EEJeffMan/NAS_Controller/README.md

# NAS_Controller
This is a PCB that serves as a controller for power supplies and provides power/reset control for a Pi-based NAS.
