EEJeffMan/NAS_Controller/PCB/BOM/NAS_Controller.xls

Reference | Quantity | Value | Footprint | Datasheet | Current | Voltage | Package | Mfg | P/N | Impedance | Power | Bias_Current | DCR | Vin | max | Field4 | Field5 | Field6 | Field7 | Field8 | Current - Hold | Field9 | Field10
C1 C23 C32 C44 C45 C55 C58 C64 C65 C66 C67 C7 C70 C71 C73 C74 C82 C83 C84 C93 C94 C98 | 22 | 0.1uF | Capacitors_SMD:C_0603 |  |  | ,50V" | 603 |  | GCJ188R71H104KA12D | , | , | , | , | , | ,
C12 C13 C27 C28 C29 C37 C38 C39 C53 C54 C60 C61 C77 C78 ,14,22uF" | 14 | 22uF | Capacitors_SMD:C_0805 |  |  | ,10V" | 805 |  | C2012X5R1A226M085AC | , | , | , | , | , | ,
C15 C31 C41 ,3,1000pF" | 3 | 1000pF | Capacitors_SMD:C_0603 |  |  | ,50V" | 603 |  | GCM188R71H102KA37D | , | , | , | , | , | ,
C17 C21 C85 C86 ,4,2.2uF" | 4 | 2.2uF | Capacitors_SMD:C_1206 |  |  | ,50V" | 1206 |  | C2012X5R1H225M085AB | , | , | , | , | , | ,
C18 C19 C47 C48 C49 C50 C51 C52 C57 C62 C63 C72 C75 C76 C80 ,15,2.2uF" | 15 | 2.2uF | Capacitors_SMD:C_0603 |  |  | ,16V" | 603 |  | CL10A225KO8NNNC | , | , | , | , | , | ,
C10 C11 C2 C24 C25 C26 C3 C34 C35 C36 C4 C5 C81 C87 C88 C89 C90 C91 C96 ,19,22uF" | 19 | 22uF | Capacitors_SMD:C_1206 |  |  | ,50V" | 1206 |  | C3216X5R1V226M160AC | , | , | , | , | , | ,
C100 C101 C102 C103 C104 C105 C106 C107 C108 C109 C110 C111 C112 C114 C14 C20 C30 C40 C6 C9 C92 C99 ,22,0.01uF" | 22 | 0.01uF | Capacitors_SMD:C_0603 |  |  | ,10V" | 603 |  | 06035C103JAT4A | GCM188R71H103KA37J | , | , | , | , | ,
C68 C69 ,2,33pF" | 2 | 33pF | Capacitors_SMD:C_0603 |  |  | ,50V" | 603 |  | CL10C330FB8NNNC | , | , | , | , | , | ,
C113 C16 C22 C33 C42 C43 C46 C56 C59 C79 C8 C95 C97 ,13,100pF" | 13 | 100pF | Capacitors_SMD:C_0603 |  |  | ,25V" | 603 |  | C0603C101M5RAC7867 | , | , | , | , | , | ,
D1 D11 D13 D21 D5 ,5,SBR8U60P5-13" | 5 | SBR8U60P5-13 | PowerDI5:Diodes_Incorporated_POWERDI_5 |  | 8A | 60V | , |  | SBR8U60P5-13 | , | , | , | , | , | ,
D14 D15 D16 D17 D18 D19 D20 | 7 | BAS40BRW-7-F | TO_SOT_Packages_SMD:SOT-363_SC-70-6 |  |  |  |  |  | BAS40BRW-7-F
D2 D6 D7 | 3 | 15MQ060NTR | Diodes_SMD:D_SMA |  | 2.1A | 60V | , |  | 15MQ060NTR | , | , | , | , | , | ,
D22 | 1 | Red | LEDs:LED_0603_HandSoldering |  |  |  |  |  | LTST-C190KRKT
D23 | 1 | Yellow | LEDs:LED_0603_HandSoldering |  |  |  |  |  | LTST-C191KSKT
D24 | 1 | Green | LEDs:LED_0603_HandSoldering |  |  |  |  |  | LTST-C190KGKT
D3 D8 | 2 | 5.6V | Diodes_SMD:D_SOD-123 |  | , | , | ,50uA" |  | MMSZ4690T3G | SZMMSZ4690ET1G | , | , | , | ,
D10 D12 D4 | 3 | 15V | Diodes_SMD:D_SOD-123 |  |  |  |  |  | MMSZ4702-TP
D9 | 1 | 3.3V | Diodes_SMD:D_SOD-123 |  |  |  |  |  | BZT52C3V3-7-F
F1 F2 F3 | 3 | 2920L300/15DR | 2920L:2920L |  | ,15V" | , | , |  | 2920L300/15DR | , | , | , | ,3A" | ,
FL1 | 1 | ACM12V-701-2PL-TL00 | CustomFootprints:IND_ACM12V-701-2PL-TL00_FixedPadNumbers |  | 8A | , | 700 Ohms |  | ACM12V-701-2PL-TL00 | , | , | , | , | , | ,
J1 | 1 | Barrel_Jack | Connectors:BARREL_JACK |  | 5A | , | , |  | PJ-002AH | , | , | , | , | ,
J10 ,1,Conn_01x10" | 1 | Conn_01x10 |  |  |  |  |  |  | PREC010SBAN-M71RC
J13 J15 | 2 | Conn_01x03 | Pin_Headers:Pin_Header_Straight_1x03_Pitch2.54mm_SMD_Pin1Right |  |  |  |  |  | 878980314
J14 | 1 | 20021121-00020C4LF | Socket_Strips:Socket_Strip_Straight_2x10_Pitch1.27mm_SMD |  |  |  |  |  | 20021121-00020C4LF
J18 | 1 | M20-9990246 | Pin_Headers:Pin_Header_Straight_1x02_Pitch2.54mm |  |  |  |  |  | M20-9990246
J2 | 1 | Conn_01x04 | Connectors_Molex:Molex_MiniFit-JR-5569-04A1_2x02x4.20mm_Angled |  |  |  |  |  | 39291048
J3 | 1 | 105133-0011 | 105133-0011:MOLEX_105133-0011 | 0.57 USD | , | , | , |  | 105133-0011 | , | 105133-0011 | Conn Micro USB Type B RCP 5 POS 0.65mm Solder ST SMD 5 Terminal 1 Port Embossed T/R | Good | None | Molex | ,
J11 J4 ,2,10103594-0001LF" | 2 | 10103594-0001LF |  |  |  |  |  |  | 10103594-0001LF
J5 J6 | 2 | NPPN101BFCN-RC | Socket_Strips:Socket_Strip_Straight_1x10_Pitch2.00mm |  |  |  |  |  | NPPN101BFCN-RC
J7 | 1 | Conn_01x03 | Pin_Headers:Pin_Header_Straight_1x03_Pitch2.54mm |  |  |  |  |  | SWR25X-NRTC-S03-ST-BA
J8 J9 | 2 | PPTC081LFBN-RC | Socket_Strips:Socket_Strip_Straight_1x08_Pitch2.54mm |  |  |  |  |  | PPTC081LFBN-RC
L1 L3 L5 | 3 | 1uH | INDP2622X120N:INDP2622X120N |  | 3.4A | , | , |  | SRP2512-1R0M | ,49 mOhm" | , | , | , | ,
L2 ,1,47uH" | 1 | 47uH | CustomFootprints:Inductor_Taiyo-Yuden_NR-80xx_HandSoldering |  | 1.55A | , | , |  | TYS8040470M-10 | , | , | , | , | ,
L4 L6 ,2,22uH" | 2 | 22uH | CustomFootprints:L_12x12mm_h8mm_hand_soldering |  | 4.3A | , | , |  | SRR1280-220M | ,38.6 mOhm" | , | , | , | ,
L7 ,1,20uH" | 1 | 20uH | CustomFootprints:IND_C_12_5MMX12_5MM_HandSoldering |  | 3.02A | , | , |  | SRF1280-100M | , | , | , | , | ,
Q1 Q10 Q4 Q6 Q8 Q9 | 6 | AOD409 | TO_SOT_Packages_SMD:TO-252-2 |  | 26A | 60V | , |  | AOD409 | , | , | , | , | , | ,
Q13 | 1 | DMN6068LK3-13 | TO_SOT_Packages_SMD:TO-252-2 |  | 6A | 60V | , |  | DMN6068LK3-13 | , | , | , | , | , | ,
Q11 Q12 Q14 Q2 Q5 Q7 | 6 | DMG1026UV-7 | digikey-footprints:SOT-563 |  |  |  |  |  | DMG1026UV-7
Q3 | 1 | FZT600BTA | TO_SOT_Packages_SMD:SOT-223 |  | 2A | 140V | , |  | FZT600BTA | CZTA14 TR | , | , | , | , | ,
R1 | 1 | 0.01 Ohm | Resistors_SMD:R_1206 |  | , | 1206 | ,1/2W" |  | ERJ-8CWFR010V | , | , | , | , | ,
R102 R115 R116 R13 R14 ,5,2.2k" | 5 | 2.2k | Resistors_SMD:R_0603 |  | , | 603 | , |  | RC0603FR-072K2L | , | , | , | , | ,
R134 ,1,649 Ohm" | 1 | 649 Ohm | Resistors_SMD:R_0603 |  | , | 603 | , |  | RC0603FR-07649RL | , | , | , | , | ,
R133 R135 R71 R85 R87 ,5,1M" | 5 | 1M | Resistors_SMD:R_0603 |  | , | 603 | , |  | MCT06030C1004FP500 | , | , | , | , | ,
R15 R32 R45 ,3,499" | 3 | 499 Ohm | Resistors_SMD:R_1206 |  | , | 1206 | , |  | ERJ-8ENF4990V | , | , | , | , | ,
R110 R111 R17 R18 R34 R36 R48 R49 R56 R58 R67 R68 ,12,49.9k" | 12 | 49.9k | Resistors_SMD:R_0603 |  | , | 603 | , |  | ERJ-3EKF4992V | , | , | , | , | ,
R10 R100 R101 R107 R109 R11 R112 R113 R118 R121 R122 R123 R124 R125 R126 R127 R128 R129 R130 R131 R132 R19 R2 R21 R22 R26 R27 R28 R35 R39 R4 R40 R41 R47 R50 R51 R52 R59 R60 R61 R69 R7 R70 R72 R73 R76 R79 R80 R81 R82 R83 R88 R89 R9 R90 R91 R92 R93 R94 R95 R97 R98 R99 ,63,10k" | 63 | 10k | Resistors_SMD:R_0603 |  | , | 603 | , |  | ERJ-3EKF1002V | , | , | , | , | ,
R20 ,1,4.3k" | 1 | 4.3k | Resistors_SMD:R_1206 |  | , | 1206 | , |  | RC1206FR-074K3L | , | , | , | , | ,
R104 R106 R12 R23 R29 R3 R30 R31 R42 R43 R44 R53 R54 R6 R64 R66 ,16,1k" | 16 | 1k | Resistors_SMD:R_0603 |  | , | 603 | , |  | ERJ-3EKF1001V | , | , | , | , | ,
R108 R16 R33 R46 R5 R57 R65 ,7,100 Ohm" | 7 | 100 Ohm | Resistors_SMD:R_0603 |  | , | 603 | , |  | ERJ-3EKF1000V | , | , | , | , | ,
R55 R74 R75 R77 R78 R84 ,6,100k" | 6 | 100k | Resistors_SMD:R_0603 |  | , | 603 | , |  | ERJ-3EKF1003V | , | , | , | , | ,
R105 R117 R119 R120 R62 R96 ,6,0 Ohm" | 6 | 0 Ohm | Resistors_SMD:R_0603 |  | , | 603 | , |  | ERJ-3GEY0R00V | , | , | , | , | ,
R103 R114 R24 R25 R37 R38 R63 R8 R86 ,9,0.1 Ohm" | 9 | 0.1 Ohm | Resistors_SMD:R_0805 |  | , | 805 | ,1/4W" |  | RUT2012FR100CS | , | , | , | , | ,
S1 ,1,1-1825027-1" | 1 | 1-1825027-1 | 1-1825027-1:SW_1-1825027-1 | Good | , | , | , |  | 1-1825027-1 | , | http://www.te.com/usa-en/product-1-1825027-1.html | Switch Push Button OFF _ON_ SPST Round Button 0.05A 24VDC Momentary Contact PC Pins Thru-Hole | TE Connectivity | 0.13 USD | Compliant | ,1-1825027-1" | None
SW1 | 1 | SW_SP3T_1COM_234 | CustomFootprints:OS103011MA7QP1 |  |  |  |  |  | OS103011MA7QP1
U1 | 1 | ZXCT1110 | digikey-footprints:SOT-753 |  |  |  |  |  | ZXCT1110W5-7
U11 | 1 | PCA6416APW,118 | Housings_SSOP:SSOP-24_5.3x8.2mm_Pitch0.65mm |  |  |  |  |  | PCA6416APW,118
U12 | 1 | ZXGD3009E6TA | TO_SOT_Packages_SMD:SOT-23-6 |  |  |  |  |  | ZXGD3009E6TA
U13 U2 U4 U5 | 4 | TS462CDT | digikey-footprints:SOIC-8_W3.9mm |  |  |  |  |  | TS462CDT
U3 | 1 | AZ1084CD-3.3 | TO_SOT_Packages_SMD:TO-252-2 |  | 5A | , | , |  | AZ1084CD-3.3TRG1 | , | 12V | , | , | , | ,
U6 | 1 | TMS320F28035PAGS | CustomFootprints:QFP50P1200X1200X120-64N_PIN1 | MCU 32-bit Piccolo F2803x C28x RISC 128KB Flash 1.8V/3.3V 64-Pin TQFP Tray | , | , | , |  | TMS320F28035PAGT | , | TMS320F28035PAGS | TQFP-64 Texas Instruments | Bad | 7.99 USD | Texas Instruments | ,
U7 ,1,MB85RS16" | 1 | MB85RS16 | digikey-footprints:SOIC-8_W3.9mm |  |  |  |  |  | MB85RS16NPNF-G-JNERE1
U8 | 1 | CY7C65634-48AXCT | Housings_QFP:LQFP-48_7x7mm_Pitch0.5mm |  |  |  |  |  | CY7C65634-48AXCT
U10 U9 | 2 | TS5A3357DCUR | Housings_SSOP:VSSOP-8_2.3x2mm_Pitch0.5mm |  |  |  |  |  | TS5A3357DCUR
Y1 | 1 | 12MHz | Crystals:Crystal_SMD_HC49-SD |  |  |  |  |  | ECS-120-20-5PX-TR
