EEJeffMan/NAS_Controller/Spice/E-Load.asc

C1: cap; 1000p
C2: cap; 44µ; Rser=0.015
C3: cap; 2.2µ
C4: cap; 2.2µ
C5: cap; 2.2µ
M2: nmos; RTR025N03
M3: nmos; RTR025N03
R1: res; 100k
R2: res; 100k
R3: res; 1k
R4: res; 100
R5: res; 1k
R6: res; 0.1
R7: res; 1k
U2: LTC6240
V1: voltage; 4.5
V3: voltage; PULSE(0 3.3 0 0.1u 0.1u 0.5u 10u)
Named nets: 0
.tran 0 25m 0 0.01u startup
