EEJeffMan/NAS_Controller/Spice/5V2 Plant Rev02.asc

C1: cap; 22µ; Rser=3m
C2: cap; 22µ; Rser=3m
C3: cap; 22µ; Rser=3m
C4: cap; 22µ; Rser=3m
C5: cap; 22µ; Rser=3m
D1: schottky; RBR30NS30A
L1: ind; 1µ; Rser=49m
L2: ind; 10µ; Rser=60m
M1: pmos; AO6407
R1: res; 20k
R2: res; 0.05
V1: voltage; 12
V2: voltage; PULSE(0 12 10u 1n 1n 0.27u 1u)
Named nets: 0
.tran 300u
