EEJeffMan/NAS_Controller/Spice/Vaux Plant.asc

C1: cap; 10µ
C2: cap; 1µ
D1: schottky; PDS760
L1: ind; 47µ
M1: pmos; FDR840P
R1: res; 4
V1: voltage; 12
V2: voltage; PULSE(0 12 0 1n 1n 0.666u 2u)
Named nets: 0
.tran 1m
