EEJeffMan/NAS_Controller/Spice/Gate Drive Circuit2.asc

C1: cap; 44µ
D1: schottky; MBRS340
L1: ind; 47µ
M1: pmos; AO6407
M2: nmos; 2N7002
M3: pmos; IRF9640
M4: nmos; 2N7002
R1: res; 4
R2: res; 10k
R3: res; 1
R4: res; 1k
R5: res; 1
V1: voltage; 12
V2: voltage; PULSE(0 12 0 1n 1n 22.2u 66.7u)
V3: voltage; PULSE(0 12 22.2u 1n 1n 44.5u 66.7u)
Named nets: 0
.tran 2m
