EEJeffMan/NAS_Controller/Spice/Gate Drive Circuit.asc

C1: cap; 1000p
C2: cap; 22µF
C3: cap; 22µF
D1: zener; BZX84C15L
D2: schottky; MBRS1100
L1: ind; 47µH
M1: pmos; IRF7404
M2: nmos; 2N7002
M3: nmos; 2N7002
R1: res; 10k
R2: res; 1k
R3: res; 1000
V1: voltage; 10.5
V2: voltage; PULSE(0 3.3 0 1n 1n 2.22u 6.67u)
Named nets: 0
.tran 1000u
