EEJeffMan/NAS_Controller/PCB/NAS_Controller.kicad_pcb

## KiCad design PCB/NAS_Controller.kicad_pcb (2019-01-17)

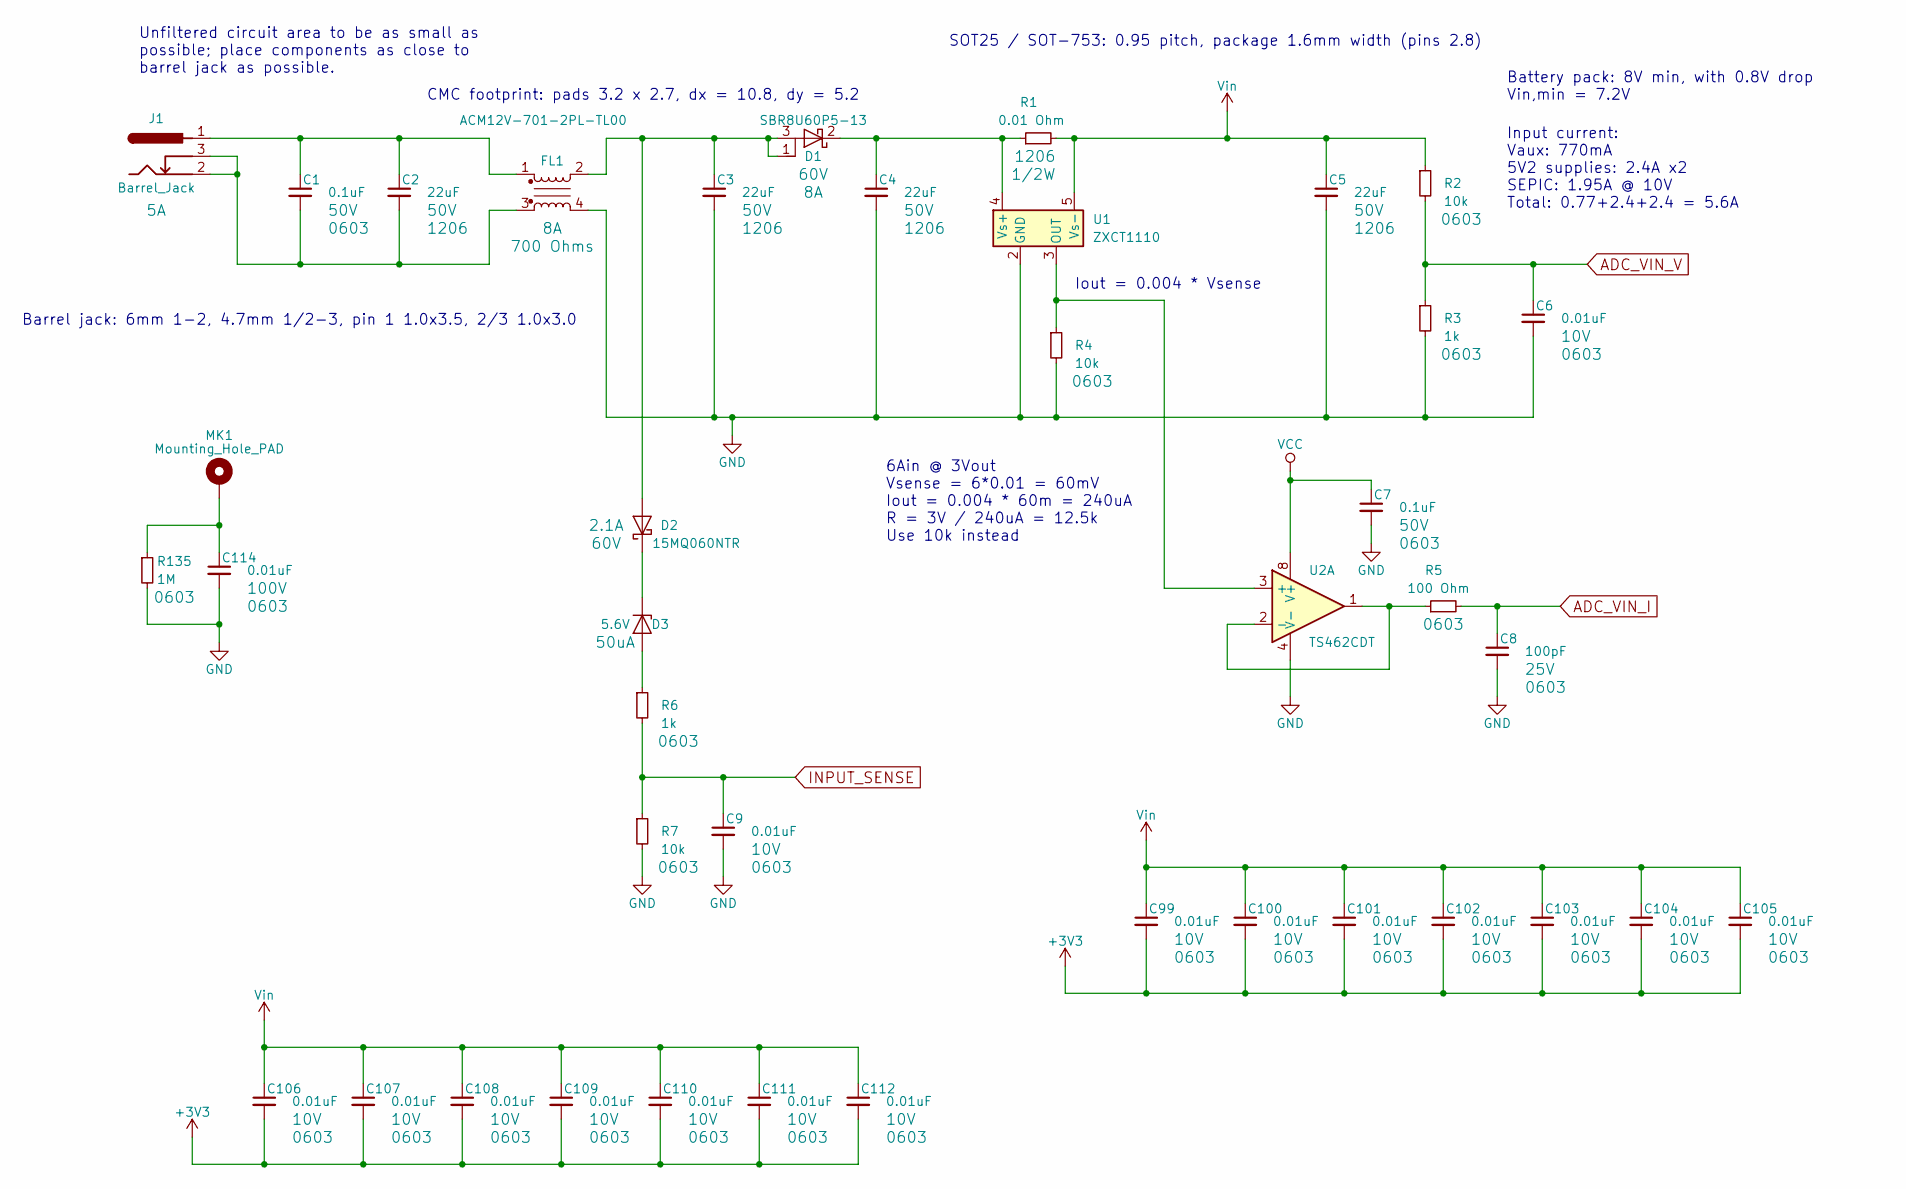
[picture p13: schematic Input.sch]

Parts:
C1, C7: 0.1uF; C_0603; Voltage 50V
C2, C3, C4, C5: 22uF; C_1206; Voltage 50V
C6, C9, C99, C100, C101, C102, C103, C104, C105, C106, C107, C108, C109, C110, C111, C112: 0.01uF; C_0603; Voltage 10V
C8: 100pF; C_0603; Voltage 25V
C114: 0.01uF; C_0603; Voltage 100V
D1: SBR8U60P5-13; Diodes_Incorporated_POWERDI_5; Voltage 60V
D2: 15MQ060NTR; D_SMA; Voltage 60V
D3: 5.6V; D_SOD-123
FL1: ACM12V-701-2PL-TL00; IND_ACM12V-701-2PL-TL00_FixedPadNumbers
J1: Barrel_Jack; BARREL_JACK
MK1: Mounting_Hole_PAD; MountingHole_4mm_Pad
R1: 0.01 Ohm; R_1206
R2, R4, R7: 10k; R_0603
R3, R6: 1k; R_0603
R5: 100 Ohm; R_0603
R135: 1M; R_0603
U1: ZXCT1110; SOT-753
U2: TS462CDT; SOIC-8_W3.9mm

Connections:
+3V3: C99.2, C100.2, C101.2, C102.2, C103.2, C104.2, C105.2, C106.2, C107.2, C108.2, C109.2, C110.2, C111.2, C112.2; also elsewhere on the board
ADC_VIN_I: C8.1, R5.2; also elsewhere on the board
ADC_VIN_V: C6.1, R2.2, R3.1; also elsewhere on the board
GND: C3.2, C4.2, C5.2, C6.2, C7.2, C8.2, C9.2, C114.2, FL1.4, R3.2, R4.2, R7.2, R135.2, U1.2 (GND), U2.4 (V-); also elsewhere on the board
INPUT_SENSE: C9.1, R6.2, R7.1; also elsewhere on the board
unnamed: C1.1, C2.1, FL1.1, J1.1
unnamed: C1.2, C2.2, FL1.3, J1.2, J1.3
unnamed: C3.1, D1.1 (A), D1.3 (A), D2.2 (A), FL1.2
unnamed: C4.1, D1.2 (K), R1.1, U1.4 (Vs+)
unnamed 74: C114.1, MK1.1, R135.1; also elsewhere on the board
unnamed: D2.1 (K), D3.1 (K)
unnamed: D3.2 (A), R6.1
unnamed: R4.1, U1.3 (OUT), U2.3 (+)
unnamed: R5.1, U2.1, U2.2 (-)
VCC: C7.1, U2.8 (V+); also elsewhere on the board
Vin: C5.1, C99.1, C100.1, C101.1, C102.1, C103.1, C104.1, C105.1, C106.1, C107.1, C108.1, C109.1, C110.1, C111.1, C112.1, R1.2, R2.1, U1.5 (Vs-); also elsewhere on the board

Notes on the sheet:
Unfiltered circuit area to be as small as possible; place components as close to barrel jack as possible.
Iout = 0.004 * Vsense
SOT25 / SOT-753: 0.95 pitch, package 1.6mm width (pins 2.8)
CMC footprint: pads 3.2 x 2.7, dx = 10.8, dy = 5.2
Barrel jack: 6mm 1-2, 4.7mm 1/2-3, pin 1 1.0x3.5, 2/3 1.0x3.0
6Ain @ 3Vout Vsense = 6*0.01 = 60mV Iout = 0.004 * 60m = 240uA R = 3V / 240uA = 12.5k Use 10k instead
Battery pack: 8V min, with 0.8V drop Vin,min = 7.2V
Input current: Vaux: 770mA 5V2 supplies: 2.4A x2 SEPIC: 1.95A @ 10V Total: 0.77+2.4+2.4 = 5.6A

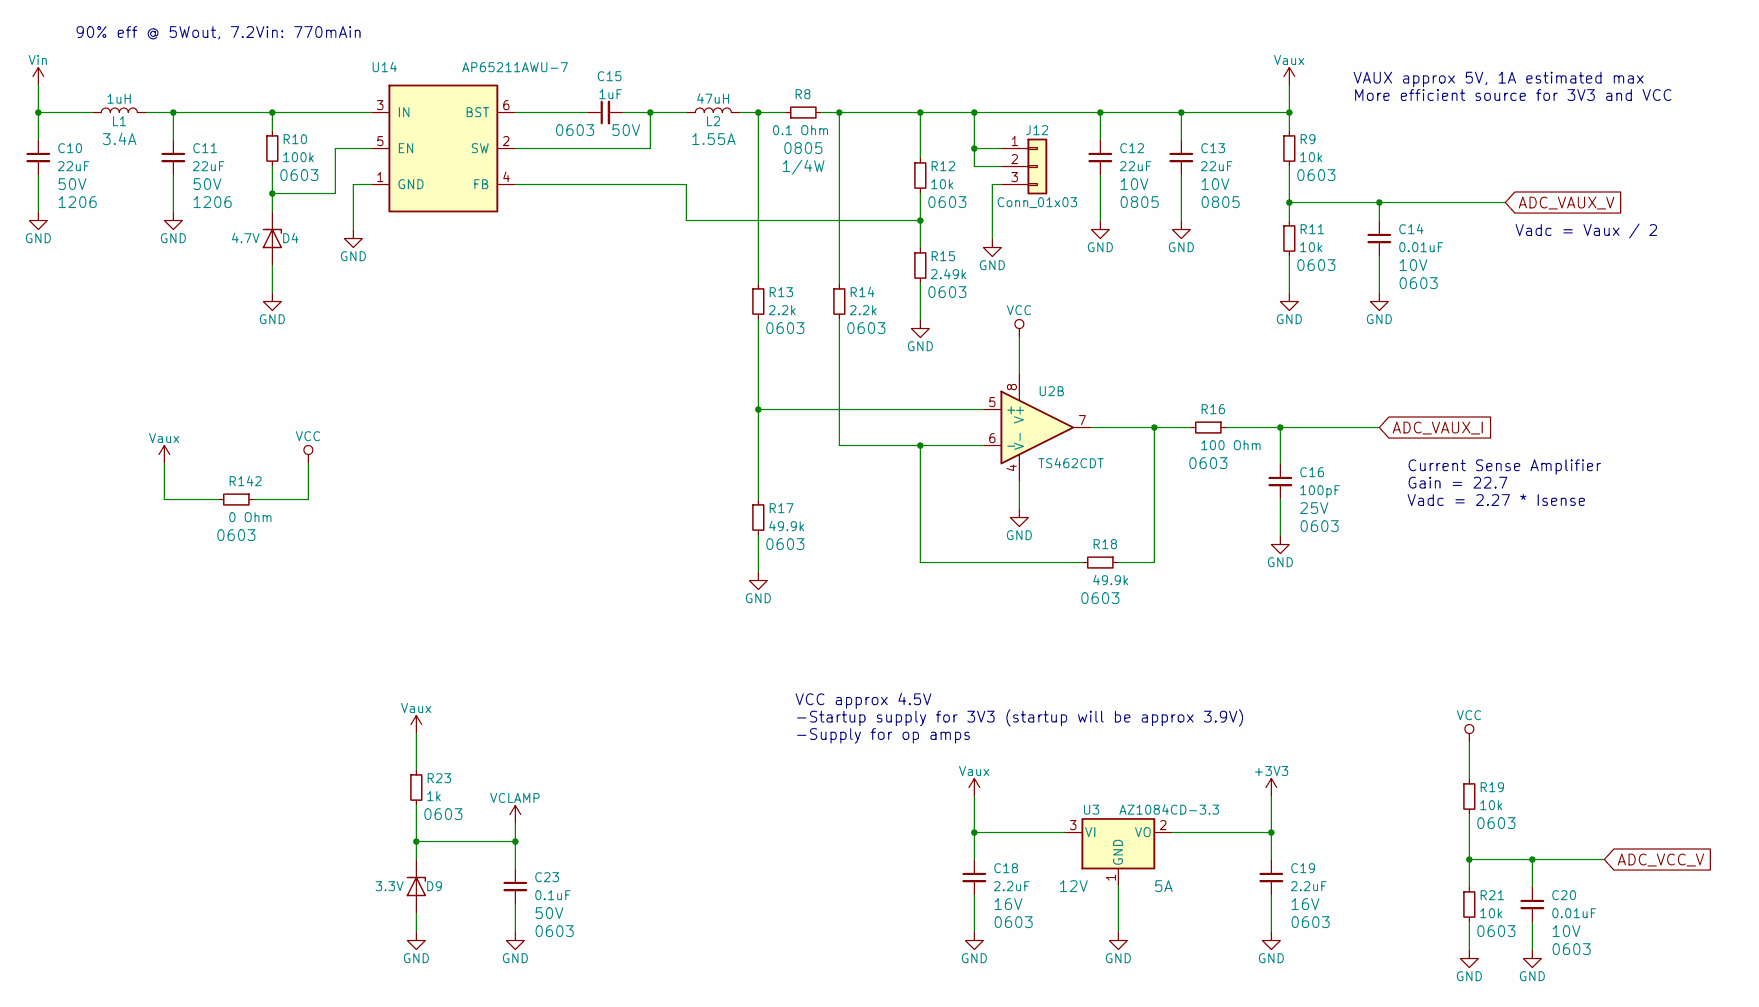
[picture p14: schematic Vaux_and_Linear.sch]

Parts:
C10, C11: 22uF; C_1206; Voltage 50V
C12, C13: 22uF; C_0805; Voltage 10V
C14, C20: 0.01uF; C_0603; Voltage 10V
C15: 1uF; C_0603; Voltage 50V
C16: 100pF; C_0603; Voltage 25V
C18, C19: 2.2uF; C_0603; Voltage 16V
C23: 0.1uF; C_0603; Voltage 50V
D4: 4.7V; D_SOD-123
D9: 3.3V; D_SOD-123
J12: Conn_01x03; Pin_Header_Straight_1x03_Pitch2.54mm_SMD_Pin1Right
L1: 1uH; INDP2622X120N
L2: 47uH; Inductor_Taiyo-Yuden_NR-80xx_HandSoldering
R8: 0.1 Ohm; R_0805
R9, R11, R12, R19, R21: 10k; R_0603
R10: 100k; R_0603
R13, R14: 2.2k; R_0603
R15: 2.49k; R_0603
R16: 100 Ohm; R_0603
R17, R18: 49.9k; R_0603
R23: 1k; R_0603
R142: 0 Ohm; R_0603
U2: TS462CDT; SOIC-8_W3.9mm
U3: AZ1084CD-3.3; TO-252-2
U14: AP65211AWU-7; SOT-23-6_Handsoldering

Connections:
+3V3: C19.1, U3.2 (VO); also elsewhere on the board
ADC_VAUX_I: C16.1, R16.1; also elsewhere on the board
ADC_VAUX_V: C14.1, R9.2, R11.1; also elsewhere on the board
ADC_VCC_V: C20.1, R19.2, R21.1; also elsewhere on the board
GND: C10.2, C11.2, C12.2, C13.2, C14.2, C16.2, C18.2, C19.2, C20.2, C23.2, D4.2 (A), D9.2 (A), J12.3, R11.2, R15.2, R17.2, R21.2, U2.4 (V-), U3.1 (GND), U14.1 (GND); also elsewhere on the board
unnamed: C11.1, L1.2, R10.1, U14.3 (IN)
unnamed: C15.1, U14.6 (BST)
unnamed: C15.2, L2.1, U14.2 (SW)
unnamed: D4.1 (K), R10.2, U14.5 (EN)
unnamed: L2.2, R8.1, R13.1
unnamed: R12.2, R15.1, U14.4 (FB)
unnamed: R13.2, R17.1, U2.5 (+)
unnamed: R14.2, R18.2, U2.6 (-)
unnamed: R16.2, R18.1, U2.7
VCC: R19.1, R142.1, U2.8 (V+); also elsewhere on the board
VCLAMP: C23.1, D9.1 (K), R23.2; also elsewhere on the board
Vaux: C12.1, C13.1, C18.1, J12.1, J12.2, R8.2, R9.1, R12.1, R14.1, R23.1, R142.2, U3.3 (VI)
Vin: C10.1, L1.1; also elsewhere on the board

Notes on the sheet:
VCC approx 4.5V -Startup supply for 3V3 (startup will be approx 3.9V) -Supply for op amps
VAUX approx 5V, 1A estimated max More efficient source for 3V3 and VCC
Current Sense Amplifier Gain = 22.7 Vadc = 2.27 * Isense
Vadc = Vaux / 2
90% eff @ 5Wout, 7.2Vin: 770mAin

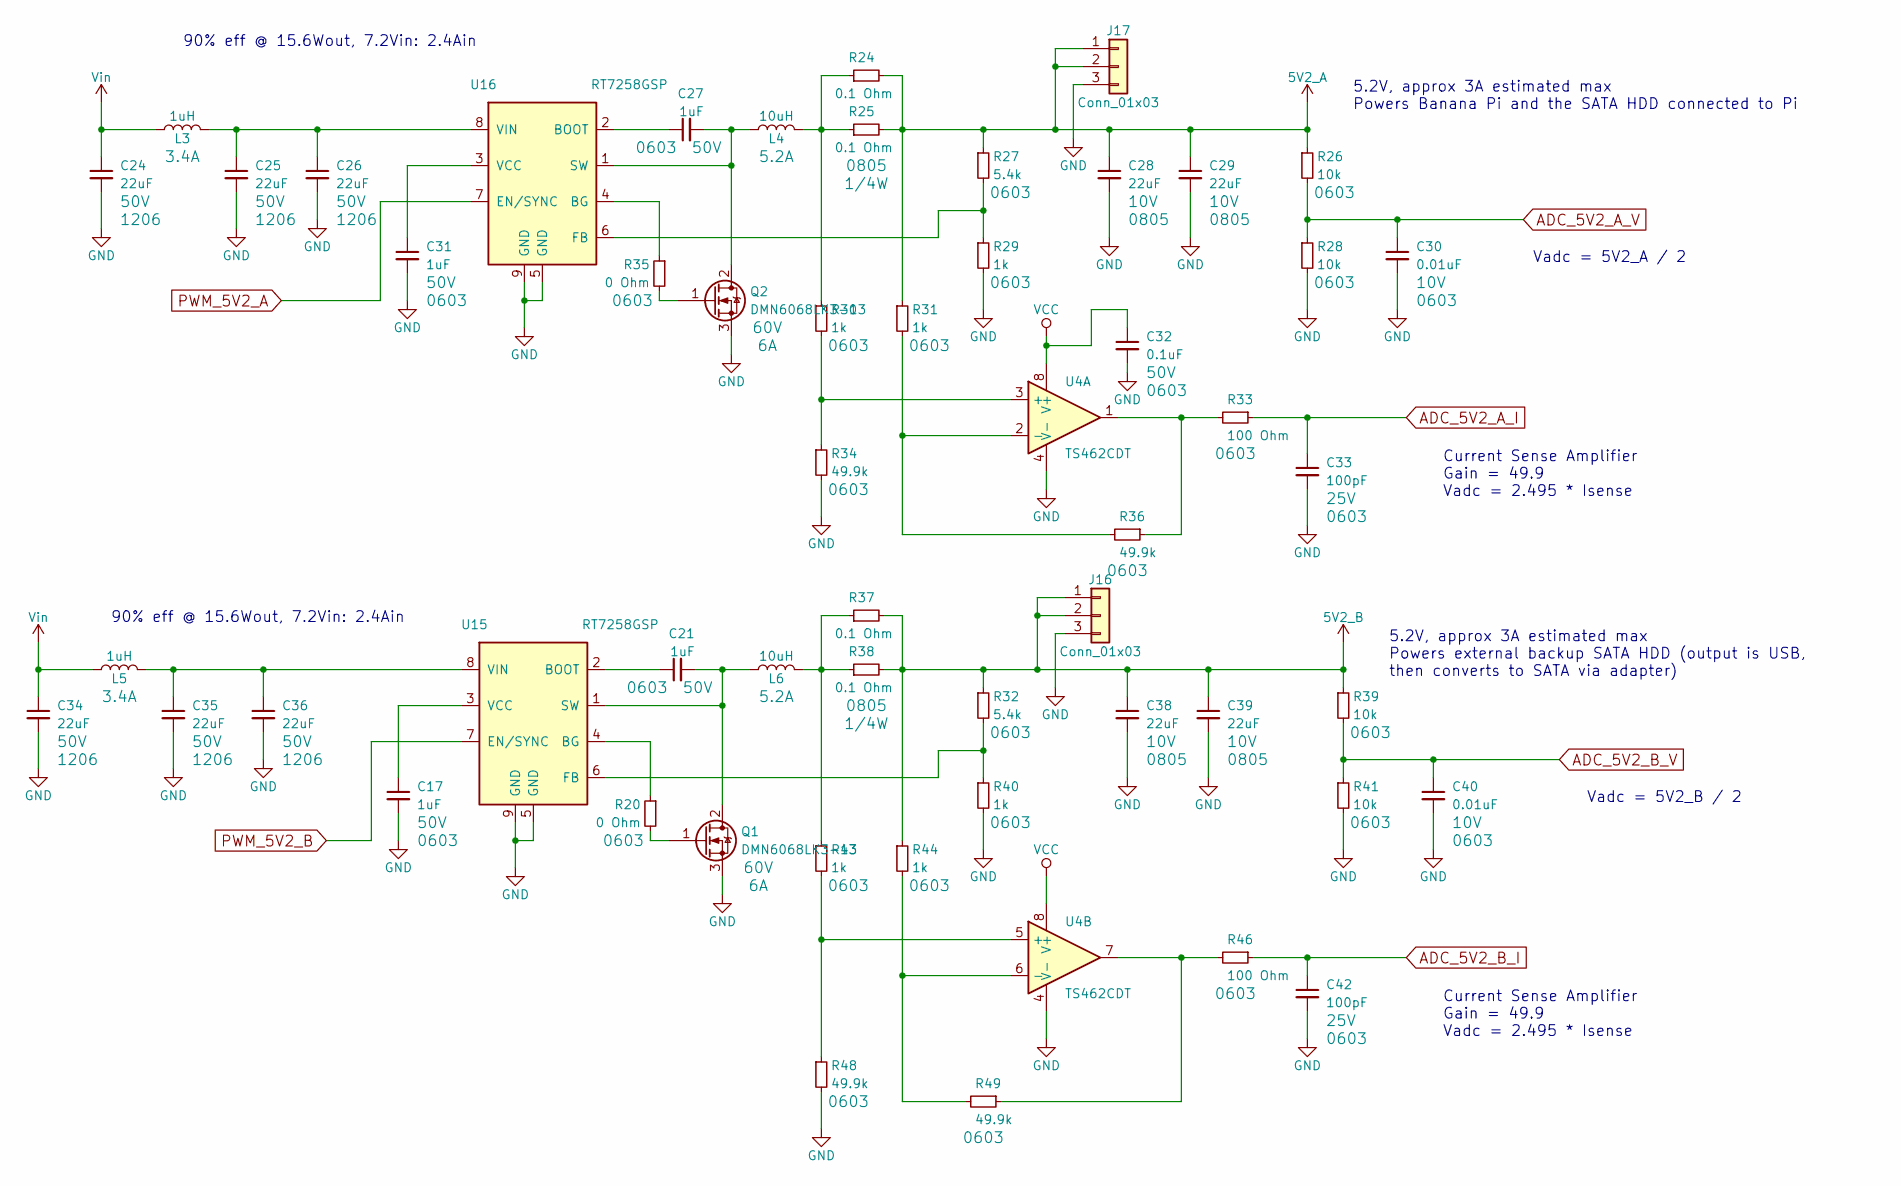
[picture p15: schematic 5V2_Supplies.sch]

Parts:
C17, C21, C27, C31: 1uF; C_0603; Voltage 50V
C24, C25, C26, C34, C35, C36: 22uF; C_1206; Voltage 50V
C28, C29, C38, C39: 22uF; C_0805; Voltage 10V
C30, C40: 0.01uF; C_0603; Voltage 10V
C32: 0.1uF; C_0603; Voltage 50V
C33, C42: 100pF; C_0603; Voltage 25V
J16, J17: Conn_01x03; Pin_Header_Straight_1x03_Pitch2.54mm_SMD_Pin1Right
L3, L5: 1uH; INDP2622X120N
L4, L6: 10uH; Inductor_Taiyo-Yuden_NR-80xx_HandSoldering
Q1, Q2: DMN6068LK3-13; TO-252-2; Voltage 60V
R20, R35: 0 Ohm; R_0603
R24, R25, R37, R38: 0.1 Ohm; R_0805
R26, R28, R39, R41: 10k; R_0603
R27, R32: 5.4k; R_0603
R29, R30, R31, R40, R43, R44: 1k; R_0603
R33, R46: 100 Ohm; R_0603
R34, R36, R48, R49: 49.9k; R_0603
U4: TS462CDT; SOIC-8_W3.9mm
U15, U16: RT7258GSP; SOIC-8-1EP_3.9x4.9mm_Pitch1.27mm_HandSoldering

Connections:
5V2_A: C28.1, C29.1, J17.1, J17.2, R24.2, R25.2, R26.1, R27.1, R31.1; also elsewhere on the board
5V2_B: C38.1, C39.1, J16.1, J16.2, R32.1, R37.2, R38.2, R39.1, R44.1; also elsewhere on the board
ADC_5V2_A_I: C33.1, R33.1; also elsewhere on the board
ADC_5V2_A_V: C30.1, R26.2, R28.1; also elsewhere on the board
ADC_5V2_B_I: C42.1, R46.1; also elsewhere on the board
ADC_5V2_B_V: C40.1, R39.2, R41.1; also elsewhere on the board
GND: C17.2, C24.2, C25.2, C26.2, C28.2, C29.2, C30.2, C31.2, C32.2, C33.2, C34.2, C35.2, C36.2, C38.2, C39.2, C40.2, C42.2, J16.3, J17.3, Q1.3 (S), Q2.3 (S), R28.2, R29.2, R34.2, R40.2, R41.2, R48.2, U4.4 (V-), U15.5 (GND), U15.9 (GND), U16.5 (GND), U16.9 (GND); also elsewhere on the board
unnamed: C17.1, U15.3 (VCC)
unnamed: C21.1, U15.2 (BOOT)
unnamed: C21.2, L6.1, Q1.2 (D), U15.1 (SW)
unnamed: C25.1, C26.1, L3.2, U16.8 (VIN)
unnamed: C27.1, U16.2 (BOOT)
unnamed: C27.2, L4.1, Q2.2 (D), U16.1 (SW)
unnamed: C31.1, U16.3 (VCC)
unnamed: C35.1, C36.1, L5.2, U15.8 (VIN)
unnamed: L4.2, R24.1, R25.1, R30.1
unnamed: L6.2, R37.1, R38.1, R43.1
unnamed: Q1.1 (G), R20.2
unnamed: Q2.1 (G), R35.2
unnamed: R20.1, U15.4 (BG)
unnamed: R27.2, R29.1, U16.6 (FB)
unnamed: R30.2, R34.1, U4.3 (+)
unnamed: R31.2, R36.2, U4.2 (-)
unnamed: R32.2, R40.1, U15.6 (FB)
unnamed: R33.2, R36.1, U4.1
unnamed: R35.1, U16.4 (BG)
unnamed: R43.2, R48.1, U4.5 (+)
unnamed: R44.2, R49.2, U4.6 (-)
unnamed: R46.2, R49.1, U4.7
PWM_5V2_A: U16.7 (EN/SYNC); also elsewhere on the board
PWM_5V2_B: U15.7 (EN/SYNC); also elsewhere on the board
VCC: C32.1, U4.8 (V+); also elsewhere on the board
Vin: C24.1, C34.1, L3.1, L5.1; also elsewhere on the board

Notes on the sheet:
5.2V, approx 3A estimated max Powers Banana Pi and the SATA HDD connected to Pi
Vadc = 5V2_A / 2
Current Sense Amplifier Gain = 49.9 Vadc = 2.495 * Isense
Vadc = 5V2_B / 2
5.2V, approx 3A estimated max Powers external backup SATA HDD (output is USB, then converts to SATA via adapter)
90% eff @ 15.6Wout, 7.2Vin: 2.4Ain

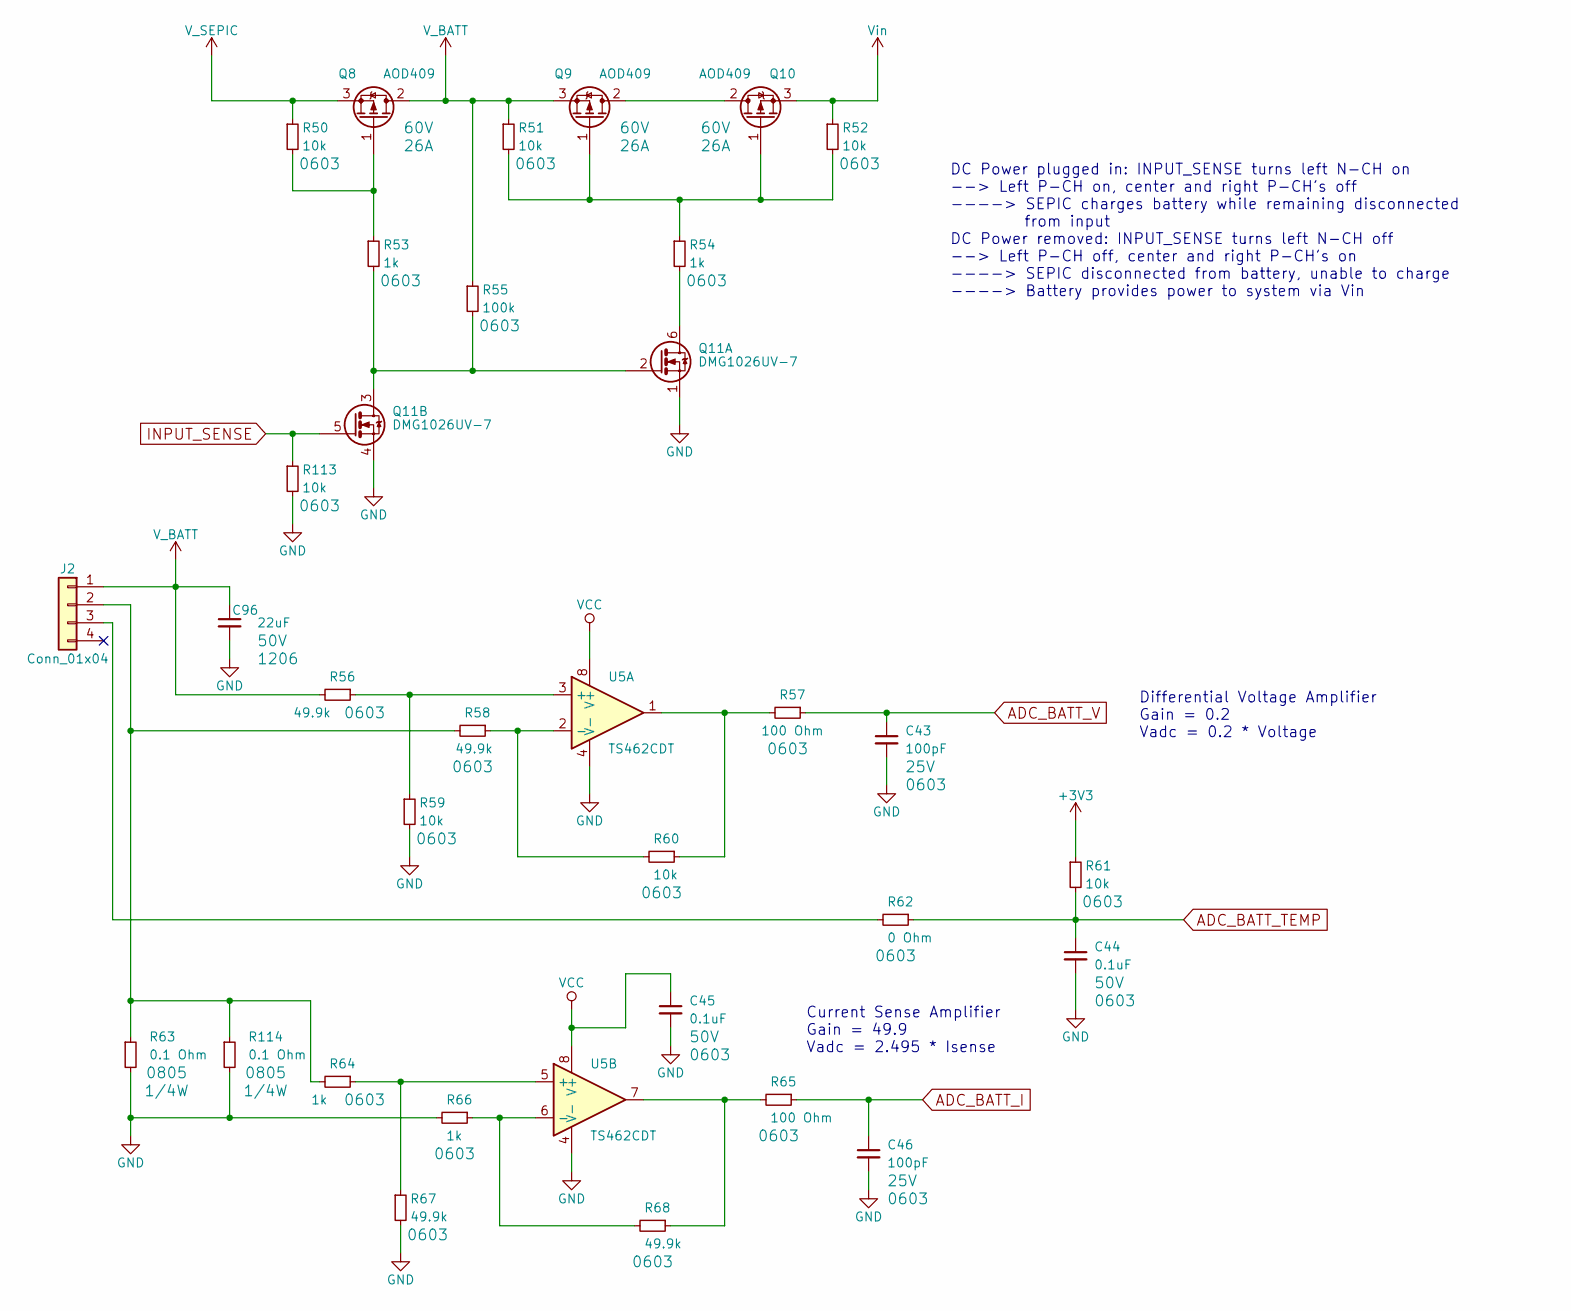
[picture p16: schematic Battery_Charger.sch]

Parts:
C43, C46: 100pF; C_0603; Voltage 25V
C44, C45: 0.1uF; C_0603; Voltage 50V
C96: 22uF; C_1206; Voltage 50V
J2: Conn_01x04; Molex_MiniFit-JR-5569-04A1_2x02x4.20mm_Angled
Q8, Q9, Q10: AOD409; TO-252-2; Voltage 60V
Q11: DMG1026UV-7; SOT-563
R50, R51, R52, R59, R60, R61, R113: 10k; R_0603
R53, R54, R64, R66: 1k; R_0603
R55: 100k; R_0603
R56, R58, R67, R68: 49.9k; R_0603
R57, R65: 100 Ohm; R_0603
R62: 0 Ohm; R_0603
R63, R114: 0.1 Ohm; R_0805
U5: TS462CDT; SOIC-8_W3.9mm

Connections:
+3V3: R61.1; also elsewhere on the board
ADC_BATT_I: C46.1, R65.1; also elsewhere on the board
ADC_BATT_TEMP: C44.1, R61.2, R62.1; also elsewhere on the board
ADC_BATT_V: C43.1, R57.1; also elsewhere on the board
GND: C43.2, C44.2, C45.2, C46.2, C96.2, Q11.1 (S), Q11.4 (S), R59.2, R63.2, R66.2, R67.2, R113.2, R114.2, U5.4 (V-); also elsewhere on the board
INPUT_SENSE: Q11.5 (G), R113.1; also elsewhere on the board
unnamed: J2.2, R58.2, R63.1, R64.2, R114.1
unnamed: J2.3, R62.2
unnamed: Q8.1 (G), R50.2, R53.1
unnamed: Q9.1 (G), Q10.1 (G), R51.2, R52.2, R54.1
unnamed: Q9.2 (D), Q10.2 (D)
unnamed: Q11.2 (G), Q11.3 (D), R53.2, R55.2
unnamed: Q11.6 (D), R54.2
unnamed: R56.1, R59.1, U5.3 (+)
unnamed: R57.2, R60.1, U5.1
unnamed: R58.1, R60.2, U5.2 (-)
unnamed: R64.1, R67.1, U5.5 (+)
unnamed: R65.2, R68.1, U5.7
unnamed: R66.1, R68.2, U5.6 (-)
VCC: C45.1, U5.8 (V+); also elsewhere on the board
V_BATT: C96.1, J2.1, Q8.2 (D), Q9.3 (S), R51.1, R55.1, R56.2
V_SEPIC: Q8.3 (S), R50.1; also elsewhere on the board
Vin: Q10.3 (S), R52.1; also elsewhere on the board

Notes on the sheet:
Current Sense Amplifier Gain = 49.9 Vadc = 2.495 * Isense
Differential Voltage Amplifier Gain = 0.2 Vadc = 0.2 * Voltage
DC Power plugged in: INPUT_SENSE turns left N-CH on --> Left P-CH on, center and right P-CH's off ----> SEPIC charges battery while remaining disconnected from input DC Power removed: INPUT_SENSE turns left N-CH off --> Left P-CH off, center and right P-CH's on ----> SEPIC disconnected from battery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

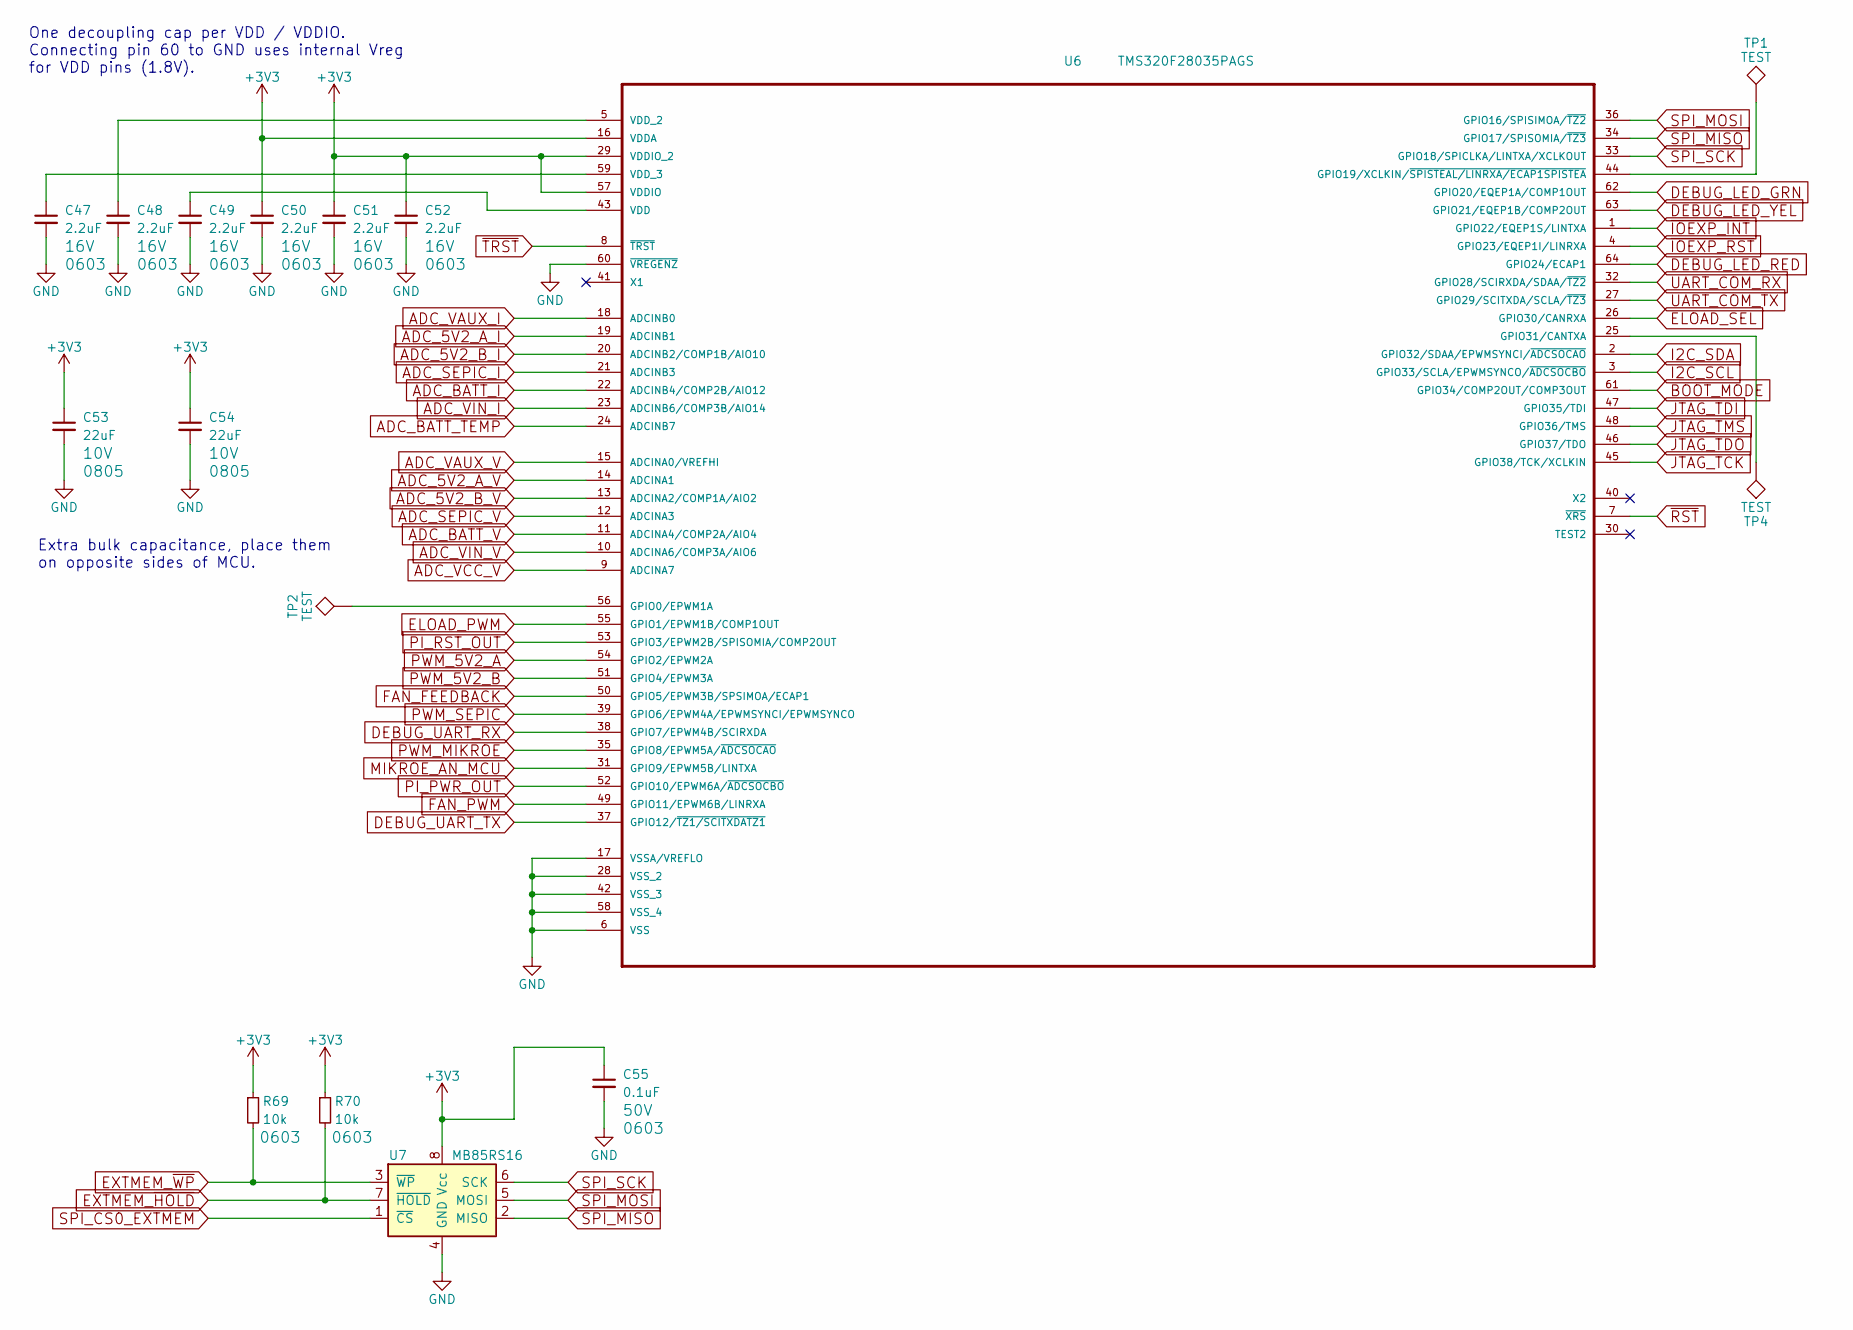
[picture p17: schematic MCU.sch]

Parts:
C47, C48, C49, C50, C51, C52: 2.2uF; C_0603; Voltage 16V
C53, C54: 22uF; C_0805; Voltage 10V
C55: 0.1uF; C_0603; Voltage 50V
R69, R70: 10k; R_0603
TP1, TP2, TP4: TEST; Measurement_Point_Round-SMD-Pad_Small
U6: TMS320F28035PAGS; QFP50P1200X1200X120-64N_PIN1
U7: MB85RS16; SOIC-8_W3.9mm

Connections:
+3V3: C50.1, C51.1, C52.1, C53.1, C54.1, C55.1, R69.1, R70.1, U6.16 (VDDA), U6.29 (VDDIO_2), U6.57 (VDDIO), U7.8 (Vcc); also elsewhere on the board
ADC_5V2_A_I: U6.19 (ADCINB1); also elsewhere on the board
ADC_5V2_A_V: U6.14 (ADCINA1); also elsewhere on the board
ADC_5V2_B_I: U6.20 (ADCINB2/COMP1B/AIO10); also elsewhere on the board
ADC_5V2_B_V: U6.13 (ADCINA2/COMP1A/AIO2); also elsewhere on the board
ADC_BATT_I: U6.22 (ADCINB4/COMP2B/AIO12); also elsewhere on the board
ADC_BATT_TEMP: U6.24 (ADCINB7); also elsewhere on the board
ADC_BATT_V: U6.11 (ADCINA4/COMP2A/AIO4); also elsewhere on the board
ADC_SEPIC_I: U6.21 (ADCINB3); also elsewhere on the board
ADC_SEPIC_V: U6.12 (ADCINA3); also elsewhere on the board
ADC_VAUX_I: U6.18 (ADCINB0); also elsewhere on the board
ADC_VAUX_V: U6.15 (ADCINA0/VREFHI); also elsewhere on the board
ADC_VCC_V: U6.9 (ADCINA7); also elsewhere on the board
ADC_VIN_I: U6.23 (ADCINB6/COMP3B/AIO14); also elsewhere on the board
ADC_VIN_V: U6.10 (ADCINA6/COMP3A/AIO6); also elsewhere on the board
BOOT_MODE: U6.61 (GPIO34/COMP2OUT/COMP3OUT); also elsewhere on the board
DEBUG_LED_GRN: U6.62 (GPIO20/EQEP1A/COMP1OUT); also elsewhere on the board
DEBUG_LED_RED: U6.64 (GPIO24/ECAP1); also elsewhere on the board
DEBUG_LED_YEL: U6.63 (GPIO21/EQEP1B/COMP2OUT); also elsewhere on the board
DEBUG_UART_RX: U6.38 (GPIO7/EPWM4B/SCIRXDA); also elsewhere on the board
DEBUG_UART_TX: U6.37 (GPIO12/~TZ1/SCITXDATZ1); also elsewhere on the board
ELOAD_PWM: U6.55 (GPIO1/EPWM1B/COMP1OUT); also elsewhere on the board
ELOAD_SEL: U6.26 (GPIO30/CANRXA); also elsewhere on the board
EXTMEM_~HOLD: R70.2, U7.7 (~HOLD); also elsewhere on the board
EXTMEM_~WP: R69.2, U7.3 (~WP); also elsewhere on the board
FAN_FEEDBACK: U6.50 (GPIO5/EPWM3B/SPSIMOA/ECAP1); also elsewhere on the board
FAN_PWM: U6.49 (GPIO11/EPWM6B/LINRXA); also elsewhere on the board
GND: C47.2, C48.2, C49.2, C50.2, C51.2, C52.2, C53.2, C54.2, C55.2, U6.6 (VSS), U6.17 (VSSA/VREFLO), U6.28 (VSS_2), U6.42 (VSS_3), U6.58 (VSS_4), U6.60 (~VREGENZ), U7.4 (GND); also elsewhere on the board
I2C_SCL: U6.3 (GPIO33/SCLA/EPWMSYNCO/~ADCSOCBO); also elsewhere on the board
I2C_SDA: U6.2 (GPIO32/SDAA/EPWMSYNCI/~ADCSOCAO); also elsewhere on the board
JTAG_TCK: U6.45 (GPIO38/TCK/XCLKIN); also elsewhere on the board
JTAG_TDI: U6.47 (GPIO35/TDI); also elsewhere on the board
JTAG_TDO: U6.46 (GPIO37/TDO); also elsewhere on the board
JTAG_TMS: U6.48 (GPIO36/TMS); also elsewhere on the board
MIKROE_AN_MCU: U6.31 (GPIO9/EPWM5B/LINTXA); also elsewhere on the board
unnamed: C47.1, U6.59 (VDD_3)
unnamed: C48.1, U6.5 (VDD_2)
unnamed: C49.1, U6.43 (VDD)
unnamed: TP1.1, U6.44 (GPIO19/XCLKIN/~SPISTEAL/LINRXA/ECAP1SPI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)
unnamed: TP2.1, U6.56 (GPIO0/EPWM1A)
unnamed: TP4.1, U6.25 (GPIO31/CANTXA)
PI_PWR_OUT: U6.52 (GPIO10/EPWM6A/~ADCSOCBO); also elsewhere on the board
PI_RST_OUT: U6.53 (GPIO3/EPWM2B/SPISOMIA/COMP2OUT); also elsewhere on the board
PWM_5V2_A: U6.54 (GPIO2/EPWM2A); also elsewhere on the board
PWM_5V2_B: U6.51 (GPIO4/EPWM3A); also elsewhere on the board
PWM_MIKROE: U6.35 (GPIO8/EPWM5A/~ADCSOCAO); also elsewhere on the board
PWM_SEPIC: U6.39 (GPIO6/EPWM4A/EPWMSYNCI/EPWMSYNCO); also elsewhere on the board
SPI_CS0_EXTMEM: U7.1 (~CS); also elsewhere on the board
SPI_MISO: U6.34 (GPIO17/SPISOMIA/~TZ3), U7.2 (MISO); also elsewhere on the board
SPI_MOSI: U6.36 (GPIO16/SPISIMOA/~TZ2), U7.5 (MOSI); also elsewhere on the board
SPI_SCK: U6.33 (GPIO18/SPICLKA/LINTXA/XCLKOUT), U7.6 (SCK); also elsewhere on the board
UART_COM_RX: U6.32 (GPIO28/SCIRXDA/SDAA/~TZ2); also elsewhere on the board
UART_COM_TX: U6.27 (GPIO29/SCITXDA/SCLA/~TZ3); also elsewhere on the board
~IOEXP_INT: U6.1 (GPIO22/EQEP1S/LINTXA); also elsewhere on the board
~IOEXP_RST: U6.4 (GPIO23/EQEP1I/LINRXA); also elsewhere on the board
~RST: U6.7 (~XRS); also elsewhere on the board
~TRST: U6.8 (~TRST); also elsewhere on the board

Notes on the sheet:
One decoupling cap per VDD / VDDIO. Connecting pin 60 to GND uses internal Vreg for VDD pins (1.8V).
Extra bulk capacitance, place them on opposite sides of MCU.

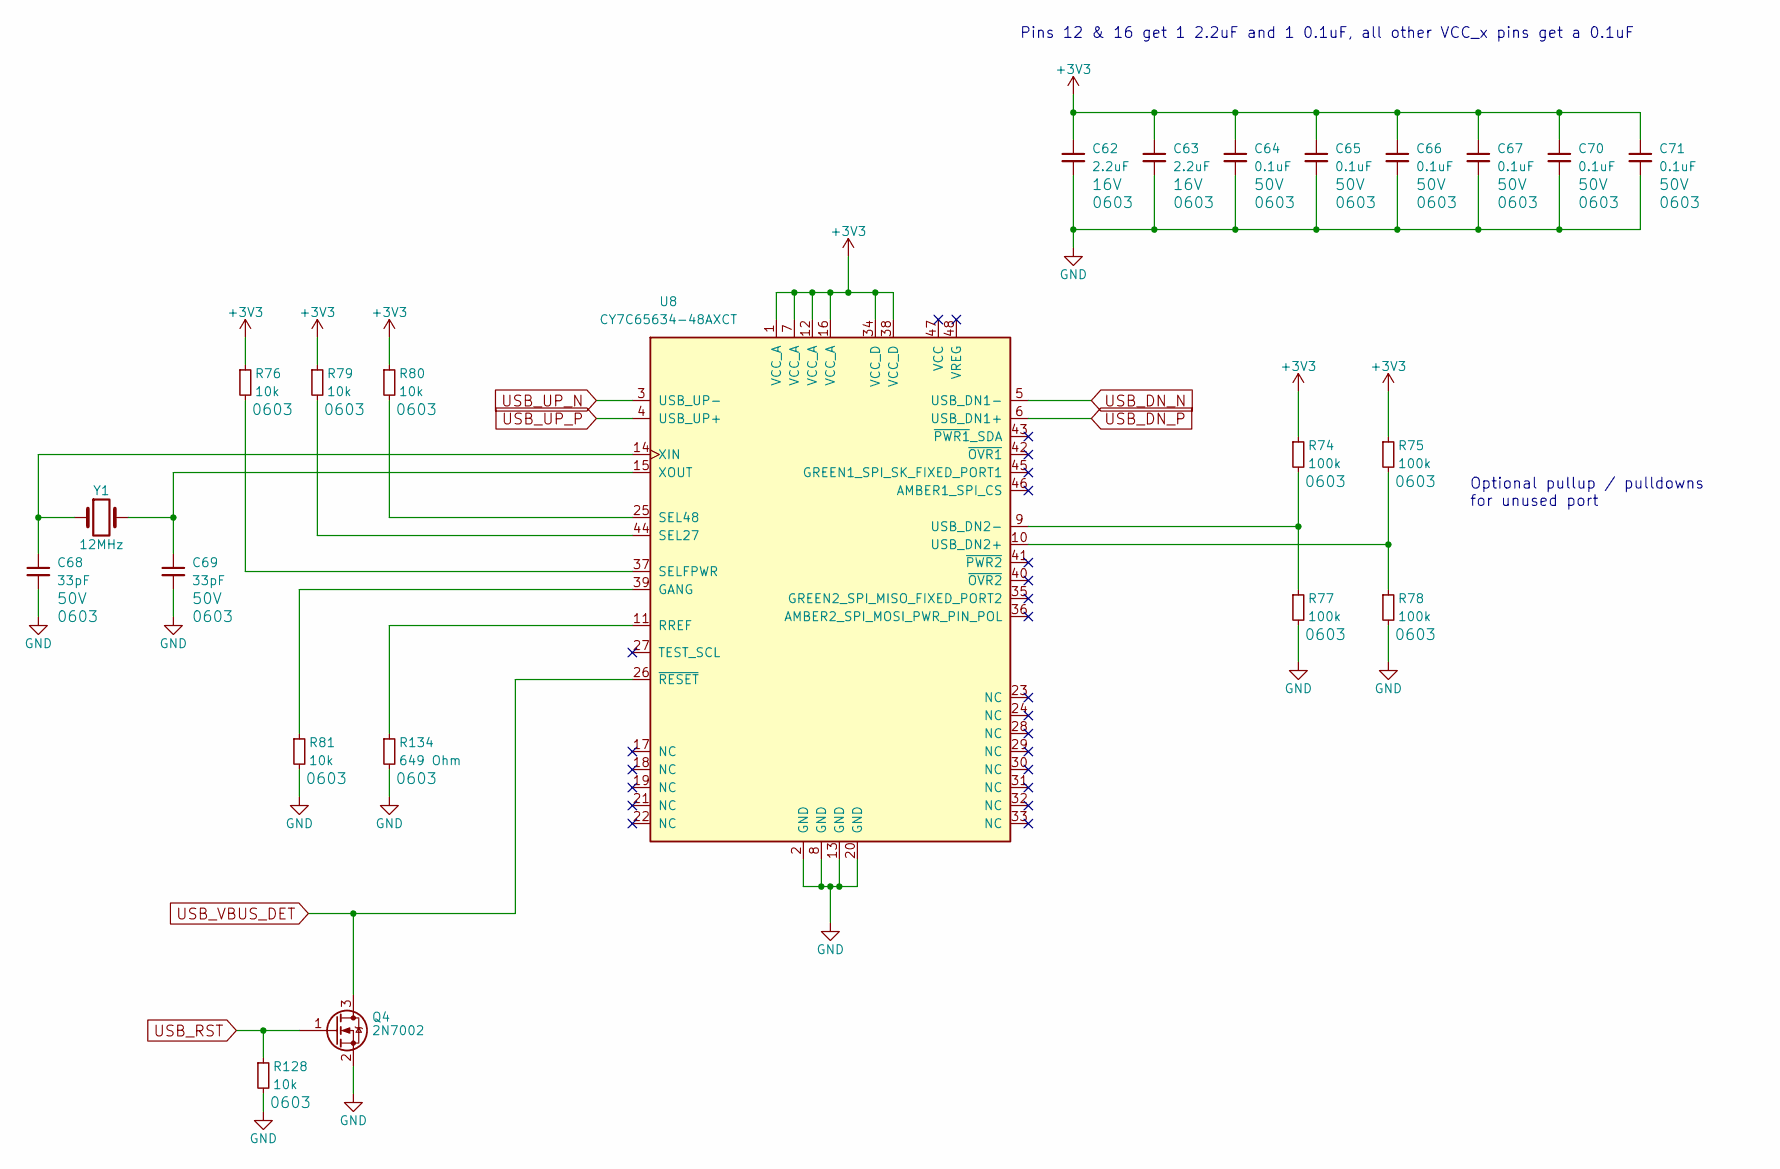
[picture p18: schematic USB.sch]

Parts:
C62, C63: 2.2uF; C_0603; Voltage 16V
C64, C65, C66, C67, C70, C71: 0.1uF; C_0603; Voltage 50V
C68, C69: 33pF; C_0603; Voltage 50V
Q4: 2N7002; SOT-23
R74, R75, R77, R78: 100k; R_0603
R76, R79, R80, R81, R128: 10k; R_0603
R134: 649 Ohm; R_0603
U8: CY7C65634-48AXCT; LQFP-48_7x7mm_Pitch0.5mm
Y1: 12MHz; Crystal_SMD_HC49-SD

Connections:
+3V3: C62.1, C63.1, C64.1, C65.1, C66.1, C67.1, C70.1, C71.1, R74.1, R75.1, R76.1, R79.1, R80.1, U8.1 (VCC_A), U8.7 (VCC_A), U8.12 (VCC_A), U8.16 (VCC_A), U8.34 (VCC_D), U8.38 (VCC_D); also elsewhere on the board
GND: C62.2, C63.2, C64.2, C65.2, C66.2, C67.2, C68.2, C69.2, C70.2, C71.2, Q4.2 (S), R77.2, R78.2, R81.2, R128.2, R134.2, U8.2 (GND), U8.8 (GND), U8.13 (GND), U8.20 (GND); also elsewhere on the board
unnamed: C68.1, U8.14 (XIN), Y1.1
unnamed: C69.1, U8.15 (XOUT), Y1.2
unnamed: R74.2, R77.1, U8.9 (USB_DN2-)
unnamed: R75.2, R78.1, U8.10 (USB_DN2+)
unnamed: R76.2, U8.37 (SELFPWR)
unnamed: R79.2, U8.44 (SEL27)
unnamed: R80.2, U8.25 (SEL48)
unnamed: R81.1, U8.39 (GANG)
unnamed: R134.1, U8.11 (RREF)
USB_DN_N: U8.5 (USB_DN1-); also elsewhere on the board
USB_DN_P: U8.6 (USB_DN1+); also elsewhere on the board
USB_RST: Q4.1 (G), R128.1; also elsewhere on the board
USB_UP_N: U8.3 (USB_UP-); also elsewhere on the board
USB_UP_P: U8.4 (USB_UP+); also elsewhere on the board
USB_VBUS_DET: Q4.3 (D), U8.26 (~RESET); also elsewhere on the board

Notes on the sheet:
Optional pullup / pulldowns for unused port
Pins 12 & 16 get 1 2.2uF and 1 0.1uF, all other VCC_x pins get a 0.1uF
