EEJeffMan/NAS_Controller/PCB/NAS_Controller.kicad_pcb

## KiCad design PCB/NAS_Controller.kicad_pcb (continued)

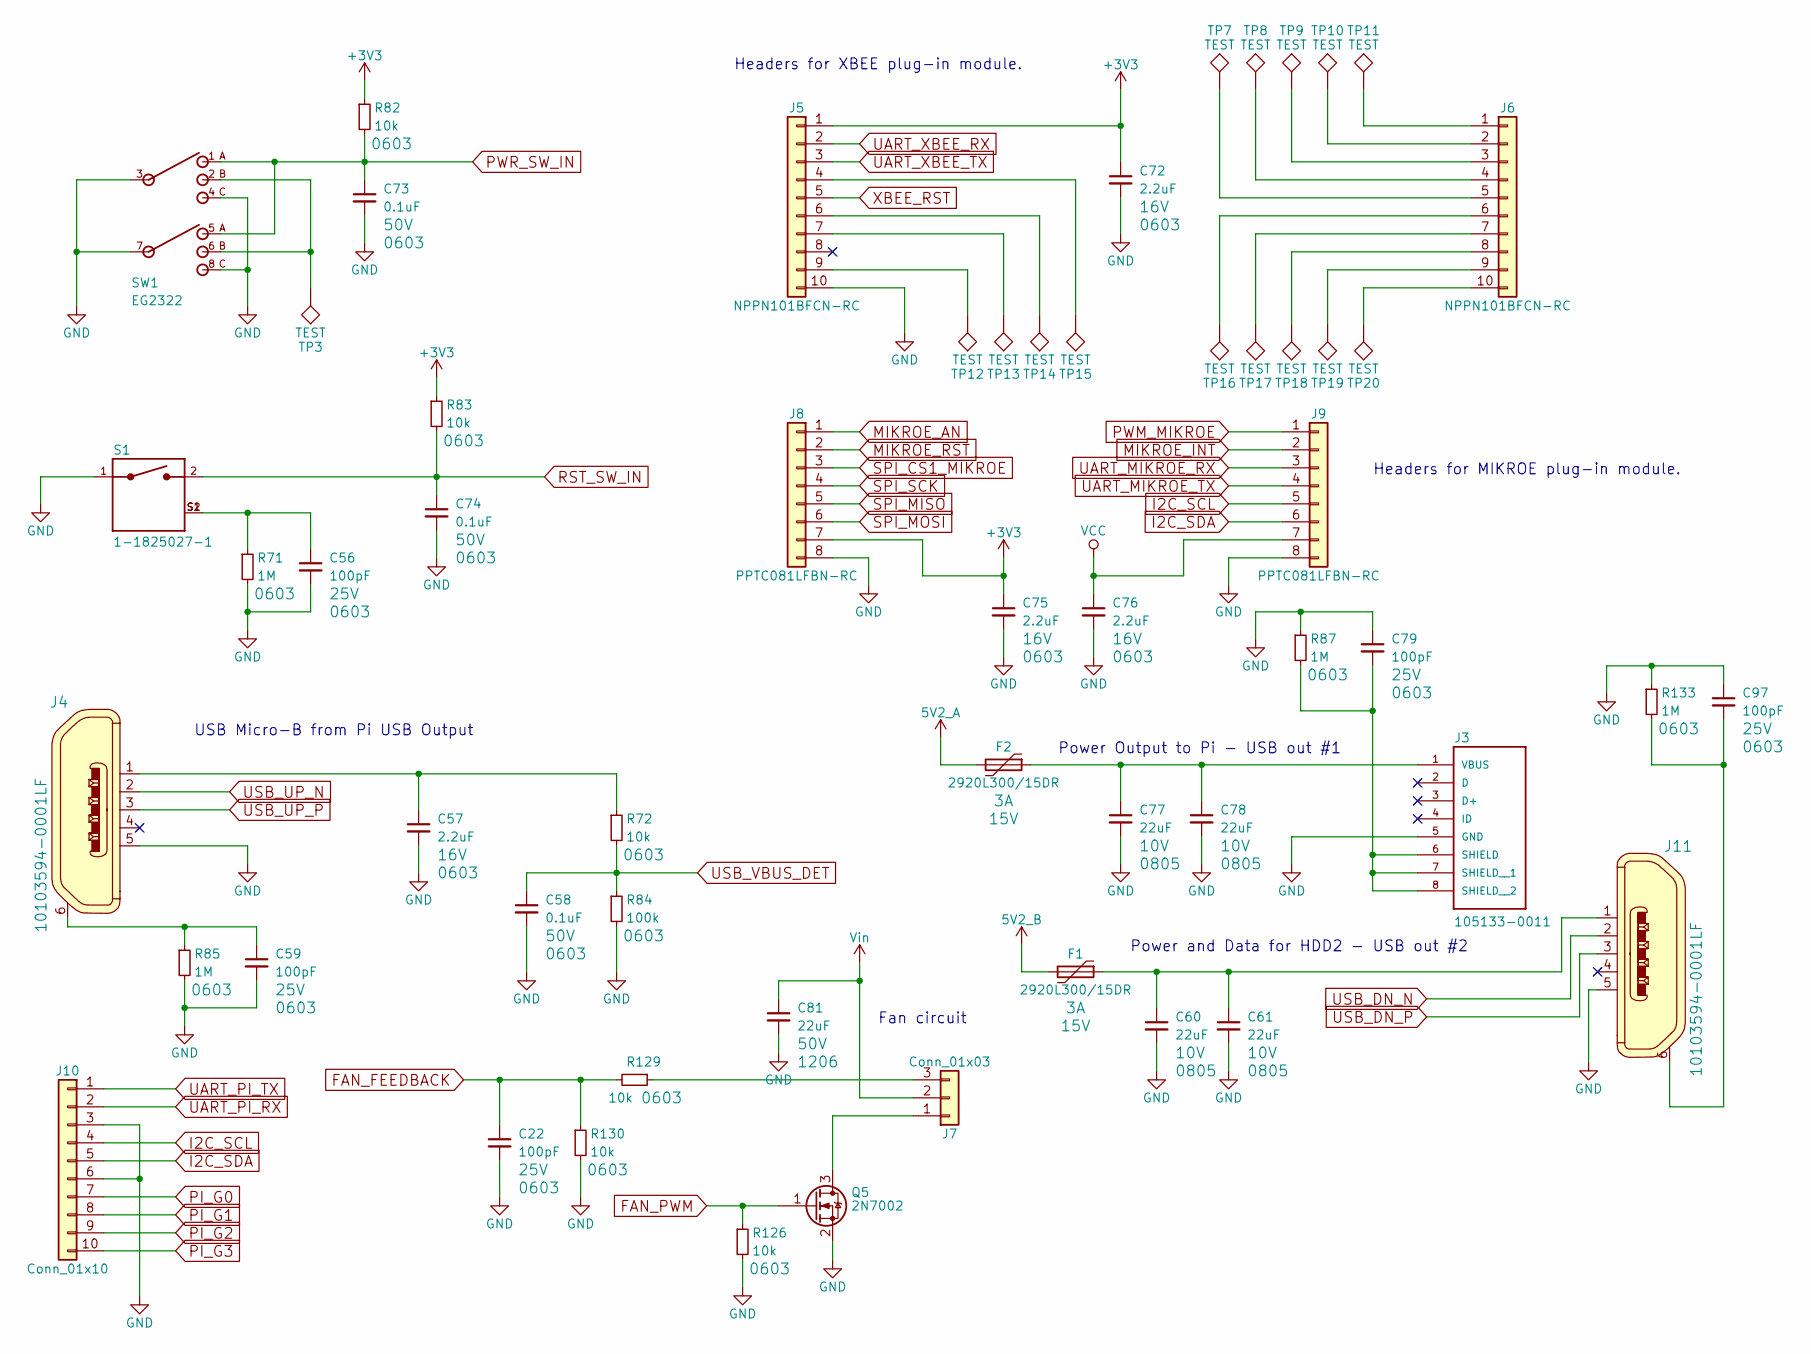
[picture p19: schematic IO.sch]

Parts:
C22, C56, C59, C79, C97: 100pF; C_0603; Voltage 25V
C57, C72, C75, C76: 2.2uF; C_0603; Voltage 16V
C58, C73, C74: 0.1uF; C_0603; Voltage 50V
C60, C61, C77, C78: 22uF; C_0805; Voltage 10V
C81: 22uF; C_1206; Voltage 50V
F1, F2: 2920L300/15DR; 2920L; Voltage 15V
J3: 105133-0011; MOLEX_105133-0011
J4, J11: 10103594-0001LF; USB_Micro-B_10103594-0001LF
J5, J6: NPPN101BFCN-RC; Socket_Strip_Straight_1x10_Pitch2.00mm
J7: Conn_01x03; Pin_Header_Straight_1x03_Pitch2.54mm
J8, J9: PPTC081LFBN-RC; Socket_Strip_Straight_1x08_Pitch2.54mm
J10: Conn_01x10; Pin_Header_Angled_1x10_Pitch2.54mm
Q5: 2N7002; SOT-23
R71, R85, R87, R133: 1M; R_0603
R72, R82, R83, R126, R129, R130: 10k; R_0603
R84: 100k; R_0603
S1: 1-1825027-1; SW_1-1825027-1
SW1: EG2322
TP3, TP7, TP8, TP9, TP10, TP11, TP12, TP13, TP14, TP15, TP16, TP17, TP18, TP19, TP20: TEST; Measurement_Point_Round-SMD-Pad_Small

Connections:
5V2_A: F2.2; also elsewhere on the board
5V2_B: F1.2; also elsewhere on the board
+3V3: C72.1, C75.1, J5.1, J8.7, R82.1, R83.1; also elsewhere on the board
FAN_FEEDBACK: C22.1, R129.2, R130.1; also elsewhere on the board
FAN_PWM: Q5.1 (G), R126.1; also elsewhere on the board
GND: C22.2, C56.2, C57.2, C58.2, C59.2, C60.2, C61.2, C72.2, C73.2, C74.2, C75.2, C76.2, C77.2, C78.2, C79.1, C81.2, C97.1, J3.5 (GND), J4.5, J5.10, J8.8, J9.8, J10.3, J10.6, J11.5, Q5.2 (S), R71.2, R84.2, R85.2, R87.1, R126.2, R130.2, R133.1, S1.1, SW1.3, SW1.4, SW1.7, SW1.8; also elsewhere on the board
I2C_SCL: J9.5, J10.4; also elsewhere on the board
I2C_SDA: J9.6, J10.5; also elsewhere on the board
MIKROE_AN: J8.1; also elsewhere on the board
MIKROE_INT: J9.2; also elsewhere on the board
MIKROE_RST: J8.2; also elsewhere on the board
unnamed: C56.1, R71.1, S1.S1 (SHIELD), S1.S2 (SHIELD)
unnamed: C57.1, J4.1, R72.1
unnamed: C59.1, J4.6, R85.1
unnamed: C60.1, C61.1, F1.1, J11.1
unnamed: C77.1, C78.1, F2.1, J3.1 (VBUS)
unnamed: C79.2, J3.6 (SHIELD), J3.7 (SHIELD__1), J3.8 (SHIELD__2), R87.2
unnamed: C97.2, J11.6, R133.2
unnamed: J5.4, TP15.1
unnamed: J5.6, TP14.1
unnamed: J5.7, TP13.1
unnamed: J5.9, TP12.1
unnamed: J6.1, TP11.1
unnamed: J6.2, TP10.1
unnamed: J6.3, TP9.1
unnamed: J6.4, TP8.1
unnamed: J6.5, TP7.1
unnamed: J6.6, TP16.1
unnamed: J6.7, TP17.1
unnamed: J6.8, TP18.1
unnamed: J6.9, TP19.1
unnamed: J6.10, TP20.1
unnamed: J7.1, Q5.3 (D)
unnamed: J7.3, R129.1
unnamed: SW1.2, SW1.6, TP3.1
PI_G0: J10.7; also elsewhere on the board
PI_G1: J10.8; also elsewhere on the board
PI_G2: J10.9; also elsewhere on the board
PI_G3: J10.10; also elsewhere on the board
PWM_MIKROE: J9.1; also elsewhere on the board
PWR_SW_IN: C73.1, R82.2, SW1.1, SW1.5; also elsewhere on the board
RST_SW_IN: C74.1, R83.2, S1.2; also elsewhere on the board
SPI_CS1_MIKROE: J8.3; also elsewhere on the board
SPI_MISO: J8.5; also elsewhere on the board
SPI_MOSI: J8.6; also elsewhere on the board
SPI_SCK: J8.4; also elsewhere on the board
UART_MIKROE_RX: J9.3; also elsewhere on the board
UART_MIKROE_TX: J9.4; also elsewhere on the board
UART_PI_RX: J10.2; also elsewhere on the board
UART_PI_TX: J10.1; also elsewhere on the board
UART_XBEE_RX: J5.2; also elsewhere on the board
UART_XBEE_TX: J5.3; also elsewhere on the board
USB_DN_N: J11.2; also elsewhere on the board
USB_DN_P: J11.3; also elsewhere on the board
USB_UP_N: J4.2; also elsewhere on the board
USB_UP_P: J4.3; also elsewhere on the board
USB_VBUS_DET: C58.1, R72.2, R84.1; also elsewhere on the board
VCC: C76.1, J9.7; also elsewhere on the board
Vin: C81.1, J7.2; also elsewhere on the board
XBEE_RST: J5.5; also elsewhere on the board

Notes on the sheet:
Headers for XBEE plug-in module.
Headers for MIKROE plug-in module.
Power Output to Pi - USB out #1
USB Micro-B from Pi USB Output
Power and Data for HDD2 - USB out #2
Fan circuit

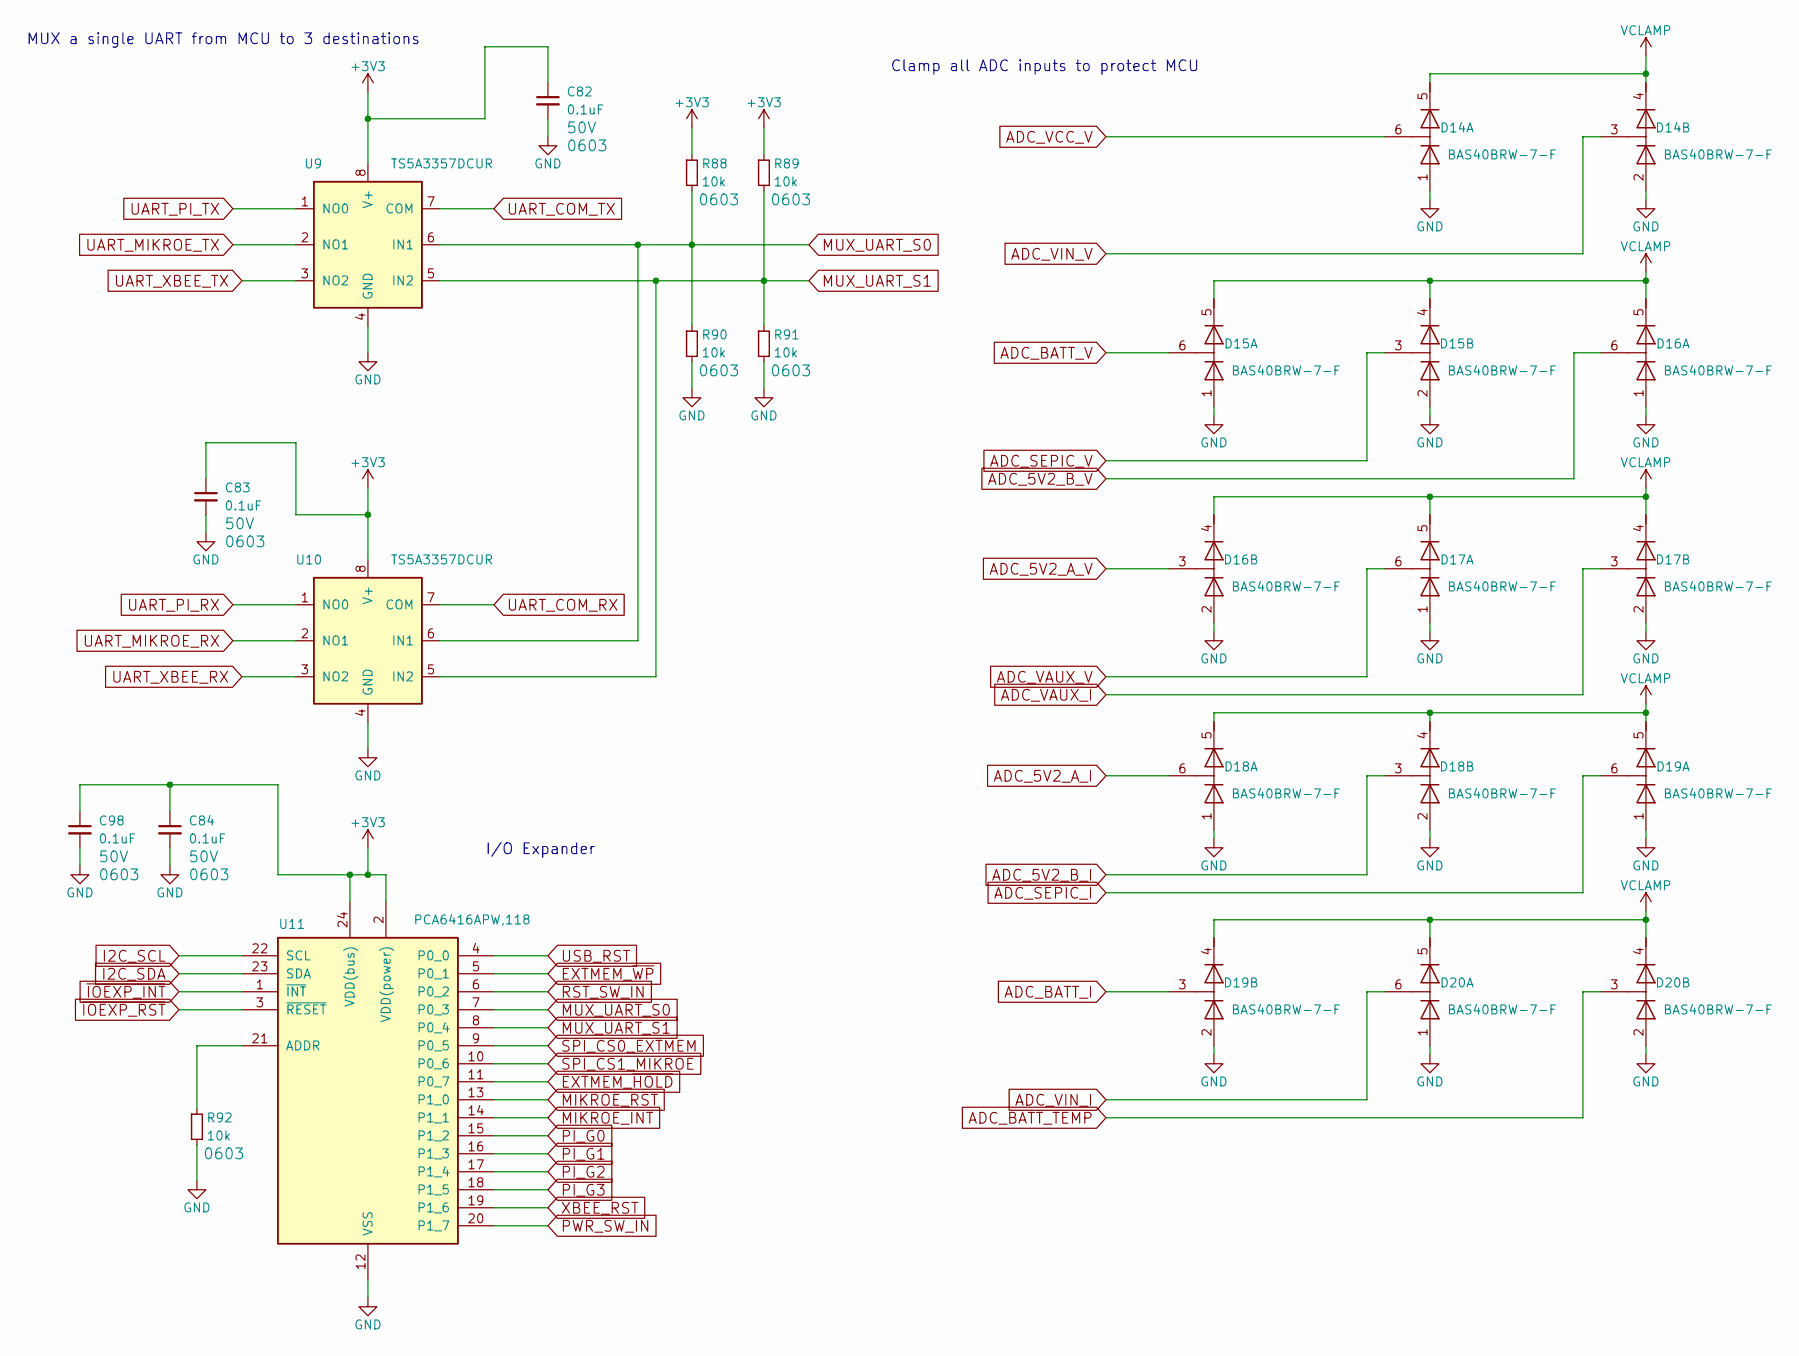
[picture p20: schematic Signal_Conditioning.sch]

Parts:
C82, C83, C84, C98: 0.1uF; C_0603; Voltage 50V
D14, D15, D16, D17, D18, D19, D20: BAS40BRW-7-F; SOT-363_SC-70-6
R88, R89, R90, R91, R92: 10k; R_0603
U9, U10: TS5A3357DCUR; VSSOP-8_2.3x2mm_Pitch0.5mm
U11: PCA6416APW,118; SSOP-24_5.3x8.2mm_Pitch0.65mm

Connections:
+3V3: C82.1, C83.1, C84.1, C98.1, R88.1, R89.1, U9.8 (V+), U10.8 (V+), U11.2 (VDD(power)), U11.24 (VDD(bus)); also elsewhere on the board
ADC_5V2_A_I: D18.6 (common); also elsewhere on the board
ADC_5V2_A_V: D16.3 (common); also elsewhere on the board
ADC_5V2_B_I: D18.3 (common); also elsewhere on the board
ADC_5V2_B_V: D16.6 (common); also elsewhere on the board
ADC_BATT_I: D19.3 (common); also elsewhere on the board
ADC_BATT_TEMP: D20.3 (common); also elsewhere on the board
ADC_BATT_V: D15.6 (common); also elsewhere on the board
ADC_SEPIC_I: D19.6 (common); also elsewhere on the board
ADC_SEPIC_V: D15.3 (common); also elsewhere on the board
ADC_VAUX_I: D17.3 (common); also elsewhere on the board
ADC_VAUX_V: D17.6 (common); also elsewhere on the board
ADC_VCC_V: D14.6 (common); also elsewhere on the board
ADC_VIN_I: D20.6 (common); also elsewhere on the board
ADC_VIN_V: D14.3 (common); also elsewhere on the board
EXTMEM_~HOLD: U11.11 (P0_7); also elsewhere on the board
EXTMEM_~WP: U11.5 (P0_1); also elsewhere on the board
GND: C82.2, C83.2, C84.2, C98.2, D14.1 (A), D14.2 (A), D15.1 (A), D15.2 (A), D16.1 (A), D16.2 (A), D17.1 (A), D17.2 (A), D18.1 (A), D18.2 (A), D19.1 (A), D19.2 (A), D20.1 (A), D20.2 (A), R90.2, R91.2, R92.2, U9.4 (GND), U10.4 (GND), U11.12 (VSS); also elsewhere on the board
I2C_SCL: U11.22 (SCL); also elsewhere on the board
I2C_SDA: U11.23 (SDA); also elsewhere on the board
MIKROE_INT: U11.14 (P1_1); also elsewhere on the board
MIKROE_RST: U11.13 (P1_0); also elsewhere on the board
MUX_UART_S0: R88.2, R90.1, U9.6 (IN1), U10.6 (IN1), U11.7 (P0_3); also elsewhere on the board
MUX_UART_S1: R89.2, R91.1, U9.5 (IN2), U10.5 (IN2), U11.8 (P0_4); also elsewhere on the board
unnamed: R92.1, U11.21 (ADDR)
PI_G0: U11.15 (P1_2); also elsewhere on the board
PI_G1: U11.16 (P1_3); also elsewhere on the board
PI_G2: U11.17 (P1_4); also elsewhere on the board
PI_G3: U11.18 (P1_5); also elsewhere on the board
PWR_SW_IN: U11.20 (P1_7); also elsewhere on the board
RST_SW_IN: U11.6 (P0_2); also elsewhere on the board
SPI_CS0_EXTMEM: U11.9 (P0_5); also elsewhere on the board
SPI_CS1_MIKROE: U11.10 (P0_6); also elsewhere on the board
UART_COM_RX: U10.7 (COM); also elsewhere on the board
UART_COM_TX: U9.7 (COM); also elsewhere on the board
UART_MIKROE_RX: U10.2 (NO1); also elsewhere on the board
UART_MIKROE_TX: U9.2 (NO1); also elsewhere on the board
UART_PI_RX: U10.1 (NO0); also elsewhere on the board
UART_PI_TX: U9.1 (NO0); also elsewhere on the board
UART_XBEE_RX: U10.3 (NO2); also elsewhere on the board
UART_XBEE_TX: U9.3 (NO2); also elsewhere on the board
USB_RST: U11.4 (P0_0); also elsewhere on the board
VCLAMP: D14.4 (K), D14.5 (K), D15.4 (K), D15.5 (K), D16.4 (K), D16.5 (K), D17.4 (K), D17.5 (K), D18.4 (K), D18.5 (K), D19.4 (K), D19.5 (K), D20.4 (K), D20.5 (K); also elsewhere on the board
XBEE_RST: U11.19 (P1_6); also elsewhere on the board
~IOEXP_INT: U11.1 (~INT); also elsewhere on the board
~IOEXP_RST: U11.3 (~RESET); also elsewhere on the board

Notes on the sheet:
I/O Expander
MUX a single UART from MCU to 3 destinations
Clamp all ADC inputs to protect MCU

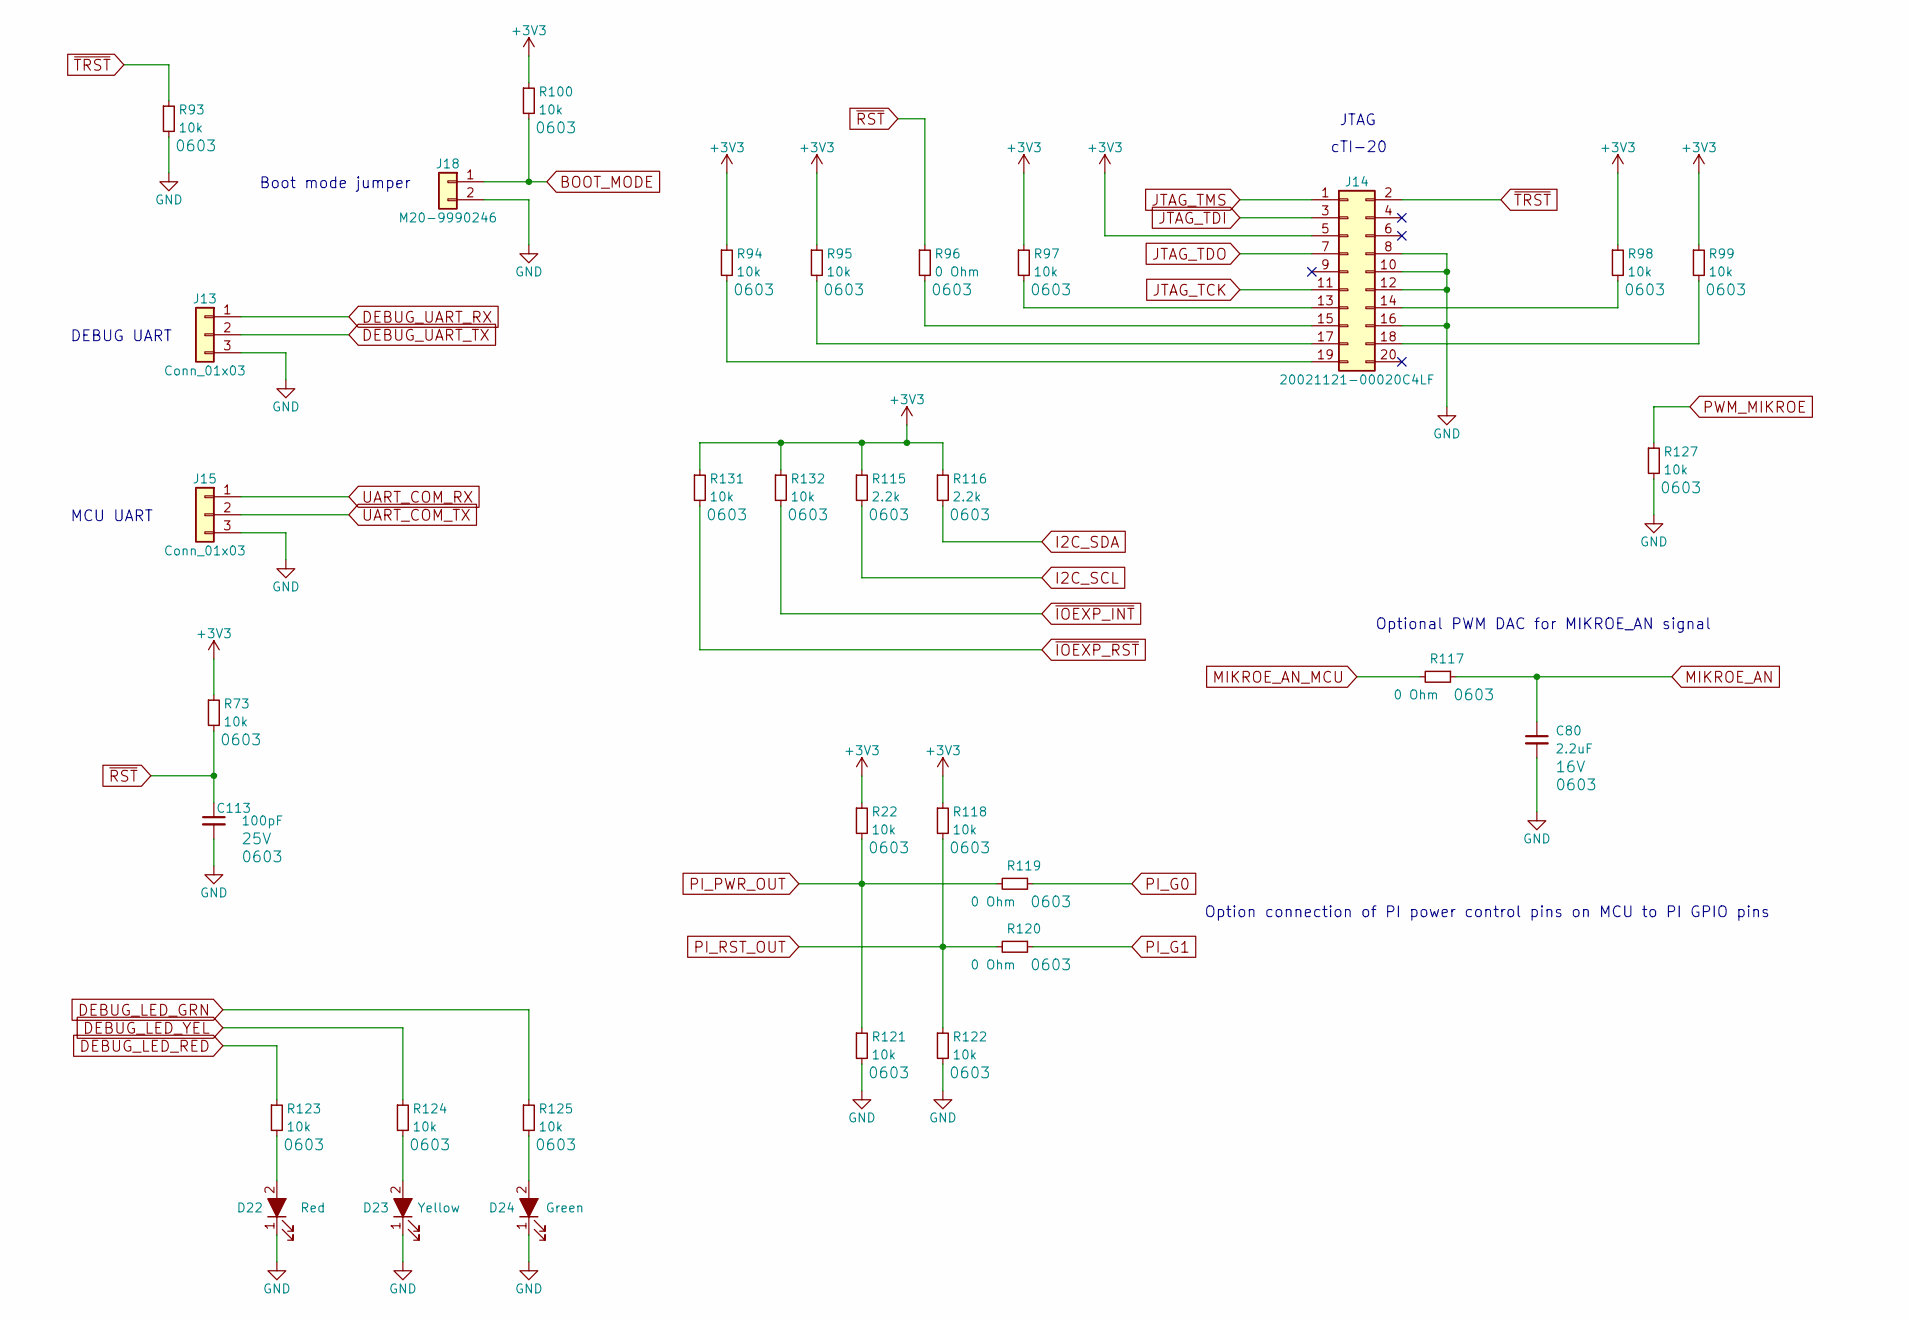
[picture p21: schematic MCU_SUPPORT.sch]

Parts:
C80: 2.2uF; C_0603; Voltage 16V
C113: 100pF; C_0603; Voltage 25V
D22: Red; LED_0603_HandSoldering
D23: Yellow; LED_0603_HandSoldering
D24: Green; LED_0603_HandSoldering
J13, J15: Conn_01x03; Pin_Header_Straight_1x03_Pitch2.54mm_SMD_Pin1Right
J14: 20021121-00020C4LF; Socket_Strip_Straight_2x10_Pitch1.27mm_SMD
J18: M20-9990246; Pin_Header_Straight_1x02_Pitch2.54mm
R22, R73, R93, R94, R95, R97, R98, R99, R100, R118, R121, R122, R123, R124, R125, R127, R131, R132: 10k; R_0603
R96, R117, R119, R120: 0 Ohm; R_0603
R115, R116: 2.2k; R_0603

Connections:
+3V3: J14.5, R22.1, R73.1, R94.1, R95.1, R97.1, R98.1, R99.1, R100.1, R115.1, R116.1, R118.1, R131.1, R132.1; also elsewhere on the board
BOOT_MODE: J18.1, R100.2; also elsewhere on the board
DEBUG_LED_GRN: R125.1; also elsewhere on the board
DEBUG_LED_RED: R123.1; also elsewhere on the board
DEBUG_LED_YEL: R124.1; also elsewhere on the board
DEBUG_UART_RX: J13.1; also elsewhere on the board
DEBUG_UART_TX: J13.2; also elsewhere on the board
GND: C80.2, C113.2, D22.1 (K), D23.1 (K), D24.1 (K), J13.3, J14.8, J14.10, J14.12, J14.16, J15.3, J18.2, R93.2, R121.2, R122.2, R127.2; also elsewhere on the board
I2C_SCL: R115.2; also elsewhere on the board
I2C_SDA: R116.2; also elsewhere on the board
JTAG_TCK: J14.11; also elsewhere on the board
JTAG_TDI: J14.3; also elsewhere on the board
JTAG_TDO: J14.7; also elsewhere on the board
JTAG_TMS: J14.1; also elsewhere on the board
MIKROE_AN: C80.1, R117.1; also elsewhere on the board
MIKROE_AN_MCU: R117.2; also elsewhere on the board
unnamed: D22.2 (A), R123.2
unnamed: D23.2 (A), R124.2
unnamed: D24.2 (A), R125.2
unnamed: J14.13, R97.2
unnamed: J14.14, R98.2
unnamed: J14.15, R96.2
unnamed: J14.17, R95.2
unnamed: J14.18, R99.2
unnamed: J14.19, R94.2
PI_G0: R119.1; also elsewhere on the board
PI_G1: R120.1; also elsewhere on the board
PI_PWR_OUT: R22.2, R119.2, R121.1; also elsewhere on the board
PI_RST_OUT: R118.2, R120.2, R122.1; also elsewhere on the board
PWM_MIKROE: R127.1; also elsewhere on the board
UART_COM_RX: J15.1; also elsewhere on the board
UART_COM_TX: J15.2; also elsewhere on the board
~IOEXP_INT: R132.2; also elsewhere on the board
~IOEXP_RST: R131.2; also elsewhere on the board
~RST: C113.1, R73.2, R96.1; also elsewhere on the board
~TRST: J14.2, R93.1; also elsewhere on the board

Notes on the sheet:
DEBUG UART
MCU UART
Boot mode jumper
JTAG
cTI-20
Optional PWM DAC for MIKROE_AN signal
Option connection of PI power control pins on MCU to PI GPIO pins

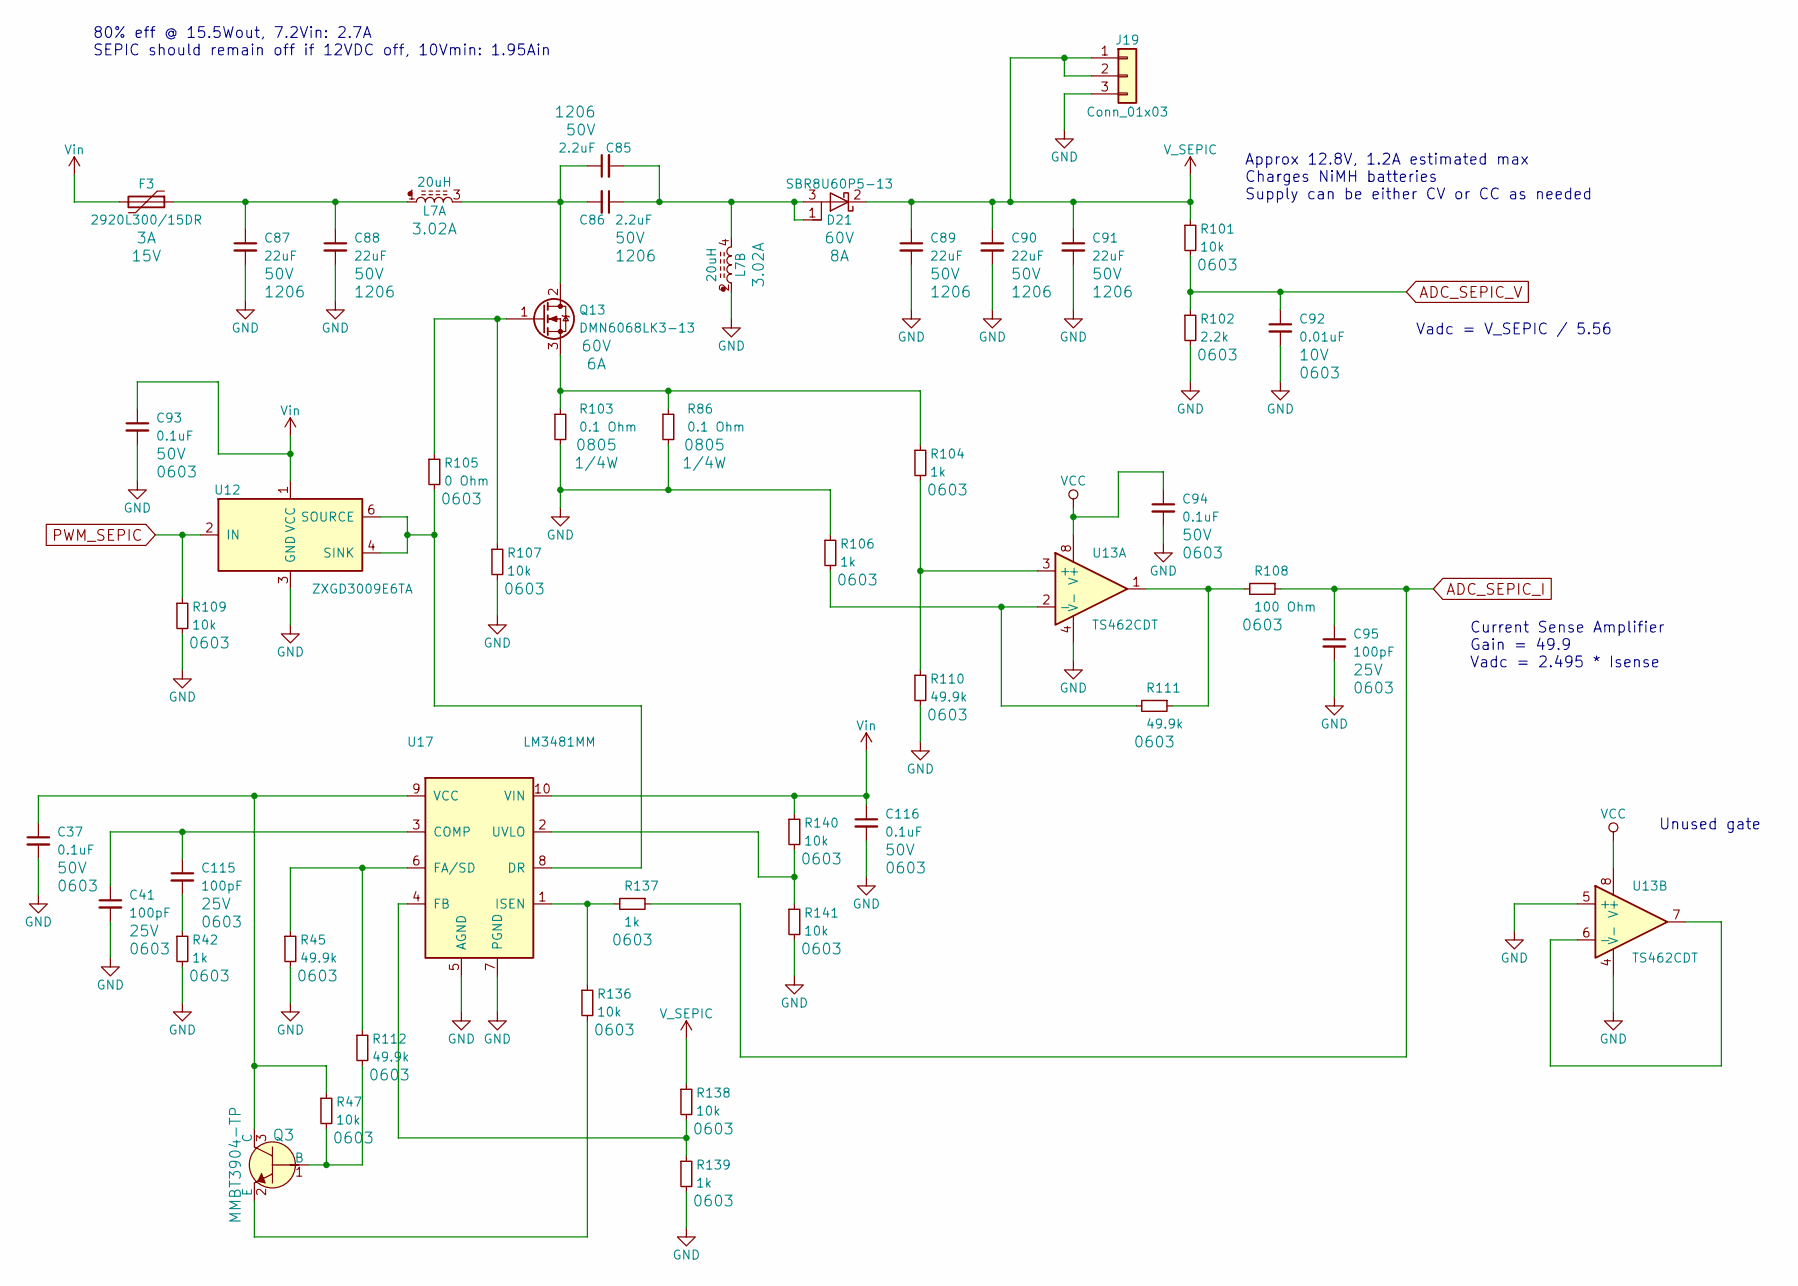
[picture p22: schematic SEPIC.sch]

Parts:
C37, C93, C94, C116: 0.1uF; C_0603; Voltage 50V
C41, C95, C115: 100pF; C_0603; Voltage 25V
C85, C86: 2.2uF; C_1206; Voltage 50V
C87, C88, C89, C90, C91: 22uF; C_1206; Voltage 50V
C92: 0.01uF; C_0603; Voltage 10V
D21: SBR8U60P5-13; Diodes_Incorporated_POWERDI_5; Voltage 60V
F3: 2920L300/15DR; 2920L; Voltage 15V
J19: Conn_01x03; Pin_Header_Straight_1x03_Pitch2.54mm_SMD_Pin1Right
L7: 20uH; IND_C_12_5MMX12_5MM_HandSoldering
Q3: MMBT3904-TP; SOT-23-3; MPN MMBT3904-TP; Digi-Key_PN MMBT3904TPMSCT-ND
Q13: DMN6068LK3-13; TO-252-2; Voltage 60V
R42, R104, R106, R137, R139: 1k; R_0603
R45, R110, R111, R112: 49.9k; R_0603
R47, R101, R107, R109, R136, R138, R140, R141: 10k; R_0603
R86, R103: 0.1 Ohm; R_0805
R102: 2.2k; R_0603
R105: 0 Ohm; R_0603
R108: 100 Ohm; R_0603
U12: ZXGD3009E6TA; SOT-23-6
U13: TS462CDT; SOIC-8_W3.9mm
U17: LM3481MM; TSSOP-10_3x3mm_Pitch0.5mm

Connections:
ADC_SEPIC_I: C95.1, R108.1, R137.1; also elsewhere on the board
ADC_SEPIC_V: C92.1, R101.2, R102.1; also elsewhere on the board
GND: C37.2, C41.2, C87.2, C88.2, C89.2, C90.2, C91.2, C92.2, C93.2, C94.2, C95.2, C116.2, J19.3, L7.2, R42.2, R45.2, R86.2, R102.2, R103.2, R106.1, R107.2, R109.2, R110.2, R139.2, R141.2, U12.3 (GND), U13.4 (V-), U13.5 (+), U17.5 (AGND), U17.7 (PGND); also elsewhere on the board
unnamed: C37.1, Q3.3 (C), R47.1, U17.9 (VCC)
unnamed: C85.1, C86.2, L7.3 (4), Q13.2 (D)
unnamed: C85.2, C86.1, D21.1 (A), D21.3 (A), L7.4
unnamed: C87.1, C88.1, F3.1, L7.1 (2)
unnamed: C41.1, C115.1, U17.3 (COMP)
unnamed: C115.2, R42.1
unnamed: Q3.1 (B), R47.2, R112.2
unnamed: Q3.2 (E), R136.2
unnamed: Q13.1 (G), R105.1, R107.1
unnamed: Q13.3 (S), R86.1, R103.1, R104.1
unnamed: R104.2, R110.1, U13.3 (+)
unnamed: R105.2, U12.4 (SINK), U12.6 (SOURCE), U17.8 (DR)
unnamed: R106.2, R111.2, U13.2 (-)
unnamed: R108.2, R111.1, U13.1
unnamed: R45.1, R112.1, U17.6 (FA/SD)
unnamed: R136.1, R137.2, U17.1 (ISEN)
unnamed: R138.2, R139.1, U17.4 (FB)
unnamed: R140.2, R141.1, U17.2 (UVLO)
unnamed: U13.6 (-), U13.7
PWM_SEPIC: R109.1, U12.2 (IN); also elsewhere on the board
VCC: C94.1, U13.8 (V+); also elsewhere on the board
V_SEPIC: C89.1, C90.1, C91.1, D21.2 (K), J19.1, J19.2, R101.1, R138.1; also elsewhere on the board
Vin: C93.1, C116.1, F3.2, R140.1, U12.1 (VCC), U17.10 (VIN); also elsewhere on the board

Notes on the sheet:
80% eff @ 15.5Wout, 7.2Vin: 2.7A SEPIC should remain off if 12VDC off, 10Vmin: 1.95Ain
Unused gate
Current Sense Amplifier Gain = 49.9 Vadc = 2.495 * Isense
Vadc = V_SEPIC / 5.56
Approx 12.8V, 1.2A estimated max Charges NiMH batteries Supply can be either CV or CC as needed

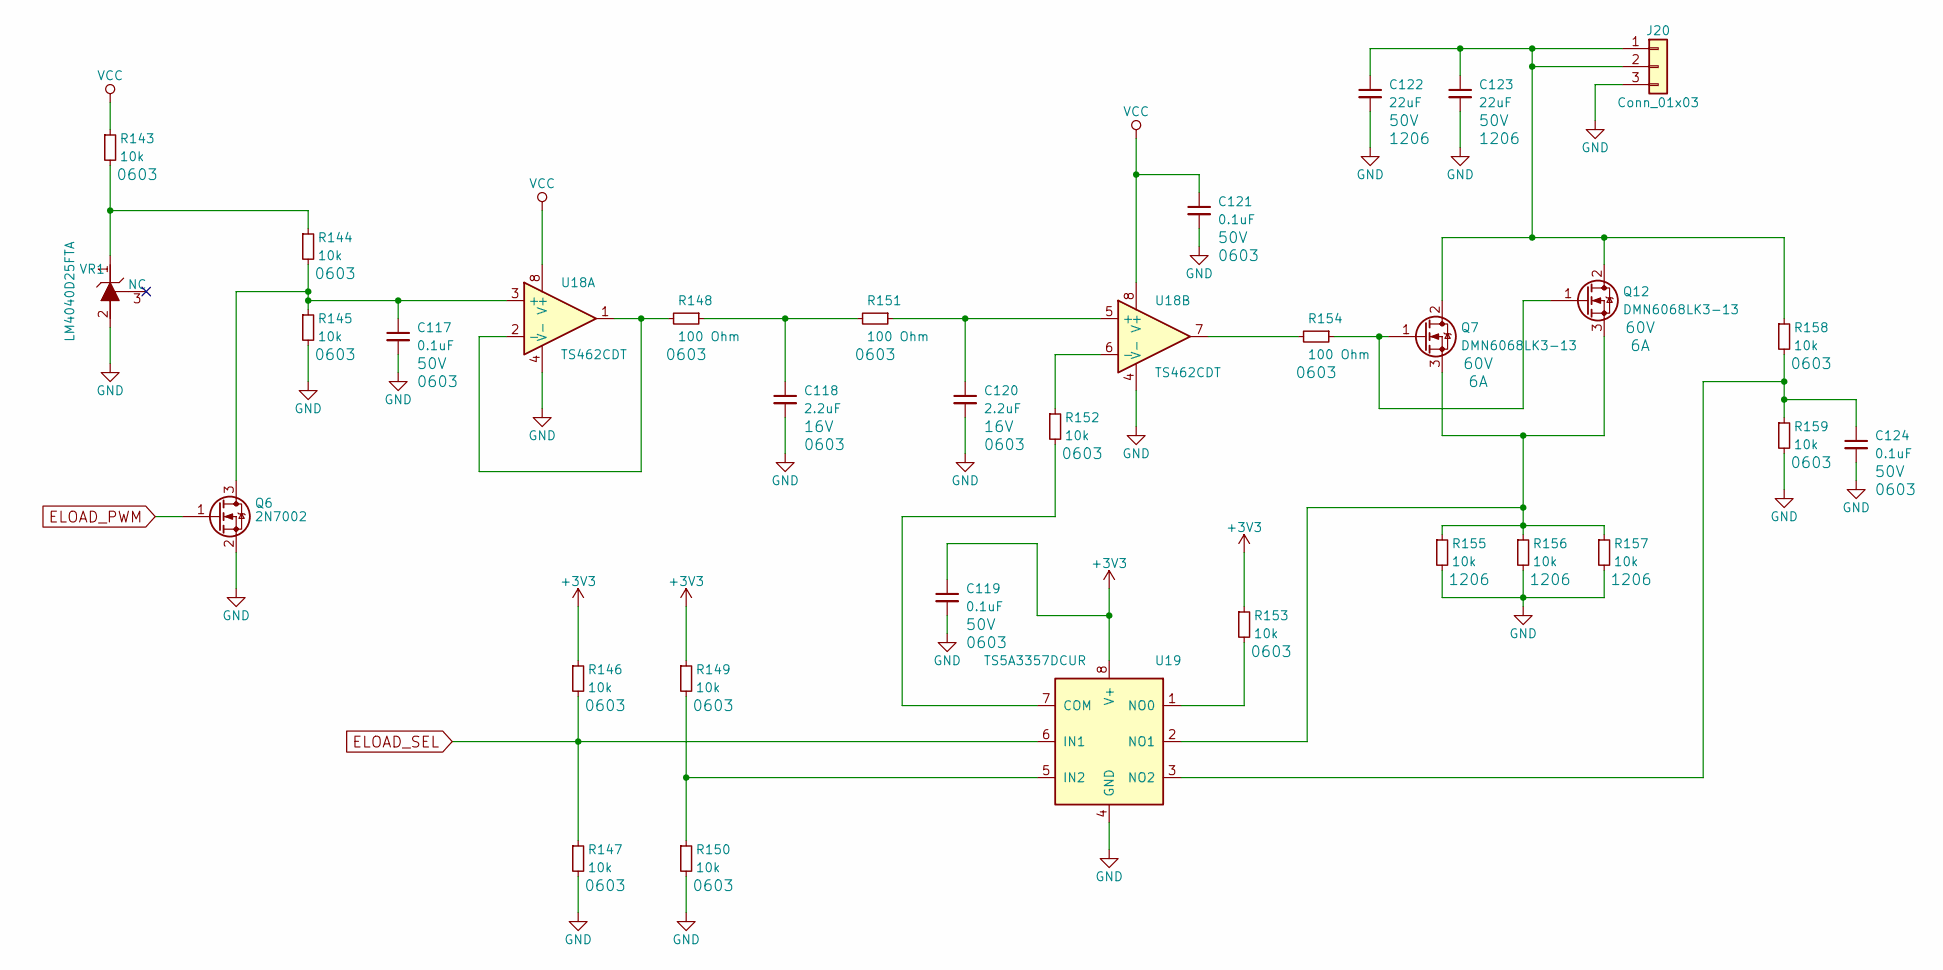
[picture p23: schematic Eload.sch, Electric_Load]

Parts:
C117, C119, C121, C124: 0.1uF; C_0603; Voltage 50V
C118, C120: 2.2uF; C_0603; Voltage 16V
C122, C123: 22uF; C_1206; Voltage 50V
J20: Conn_01x03; Pin_Header_Straight_1x03_Pitch2.54mm_SMD_Pin1Right
Q6: 2N7002; SOT-23
Q7, Q12: DMN6068LK3-13; TO-252-2; Voltage 60V
R143, R144, R145, R146, R147, R149, R150, R152, R153, R158, R159: 10k; R_0603
R148, R151, R154: 100 Ohm; R_0603
R155, R156, R157: 10k; R_1206
U18: TS462CDT; SOIC-8_W3.9mm
U19: TS5A3357DCUR; VSSOP-8_2.3x2mm_Pitch0.5mm
VR1: LM4040D25FTA; SOT-23-3; MPN LM4040D25FTA; Digi-Key_PN LM4040D25FCT-ND

Connections:
+3V3: C119.1, R146.1, R149.1, R153.1, U19.8 (V+); also elsewhere on the board
ELOAD_PWM: Q6.1 (G); also elsewhere on the board
ELOAD_SEL: R146.2, R147.1, U19.6 (IN1); also elsewhere on the board
GND: C117.2, C118.2, C119.2, C120.2, C121.2, C122.2, C123.2, C124.2, J20.3, Q6.2 (S), R145.2, R147.2, R150.2, R155.2, R156.2, R157.2, R159.2, U18.4 (V-), U19.4 (GND), VR1.2; also elsewhere on the board
unnamed: C117.1, Q6.3 (D), R144.2, R145.1, U18.3 (+)
unnamed: C118.1, R148.1, R151.2
unnamed 79: C120.1, R151.1, U18.5 (+); also elsewhere on the board
unnamed: C122.1, C123.1, J20.1, J20.2, Q7.2 (D), Q12.2 (D), R158.1
unnamed: C124.1, R158.2, R159.1, U19.3 (NO2)
unnamed: Q7.1 (G), Q12.1 (G), R154.1
unnamed: Q7.3 (S), Q12.3 (S), R155.1, R156.1, R157.1, U19.2 (NO1)
unnamed: R143.2, R144.1, VR1.1
unnamed: R148.2, U18.1, U18.2 (-)
unnamed: R149.2, R150.1, U19.5 (IN2)
unnamed: R152.1, U18.6 (-)
unnamed 181: R152.2, U19.7 (COM); also elsewhere on the board
unnamed: R153.2, U19.1 (NO0)
unnamed: R154.2, U18.7
VCC: C121.1, R143.1, U18.8 (V+); also elsewhere on the board
