EEJeffMan/NAS_Controller/PCB/NAS_Controller.kicad_pcb

## KiCad design PCB/NAS_Controller.kicad_pcb (continued)

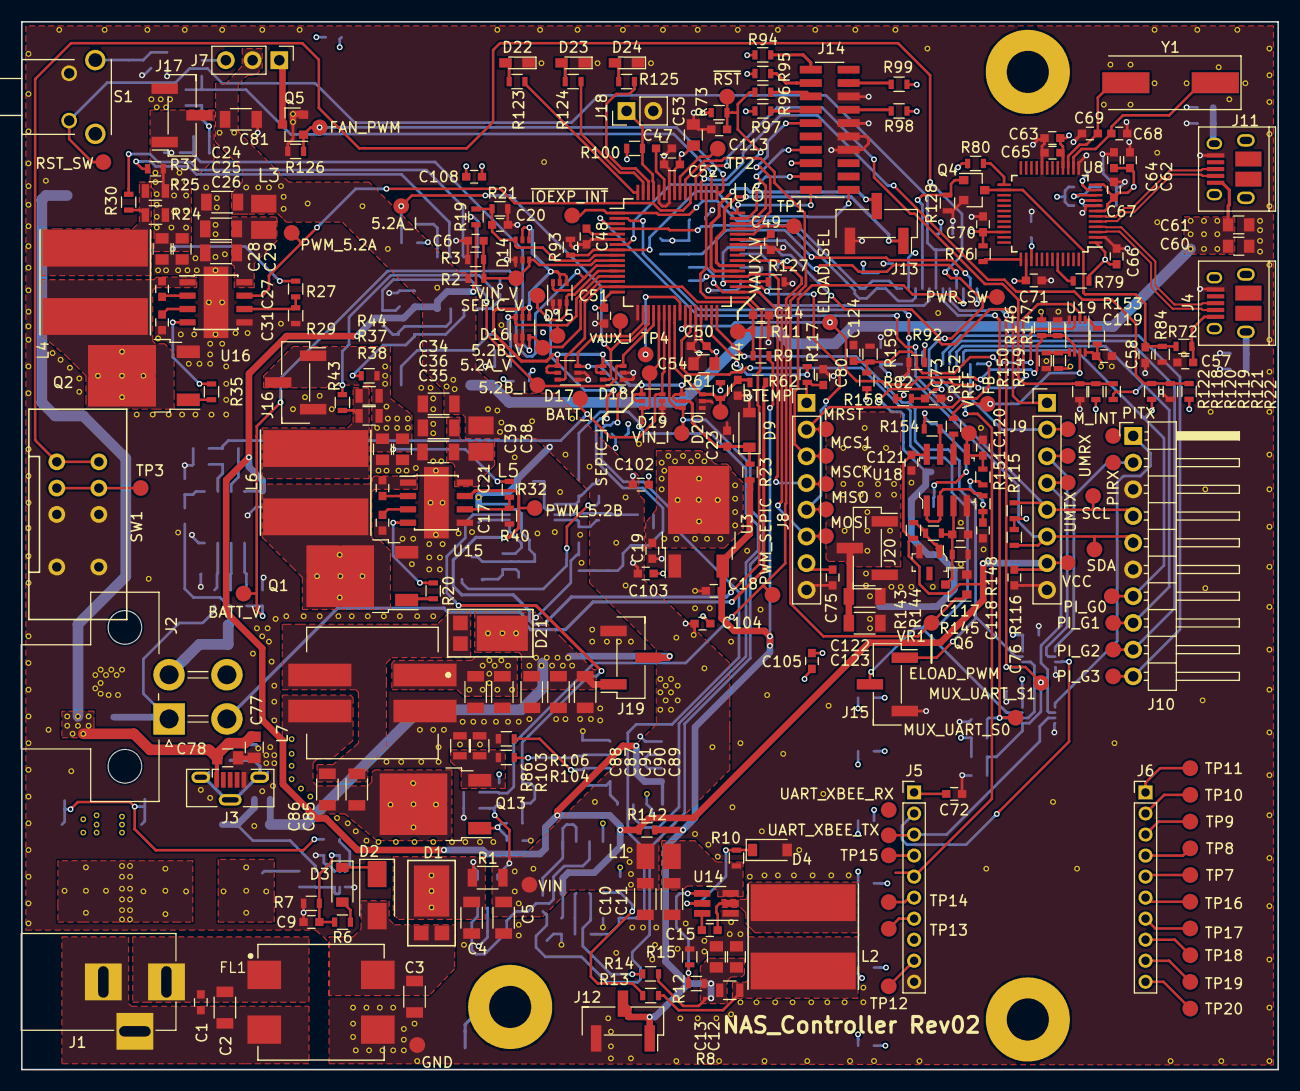
[picture p24: board NAS_Controller.kicad_pcb from above]

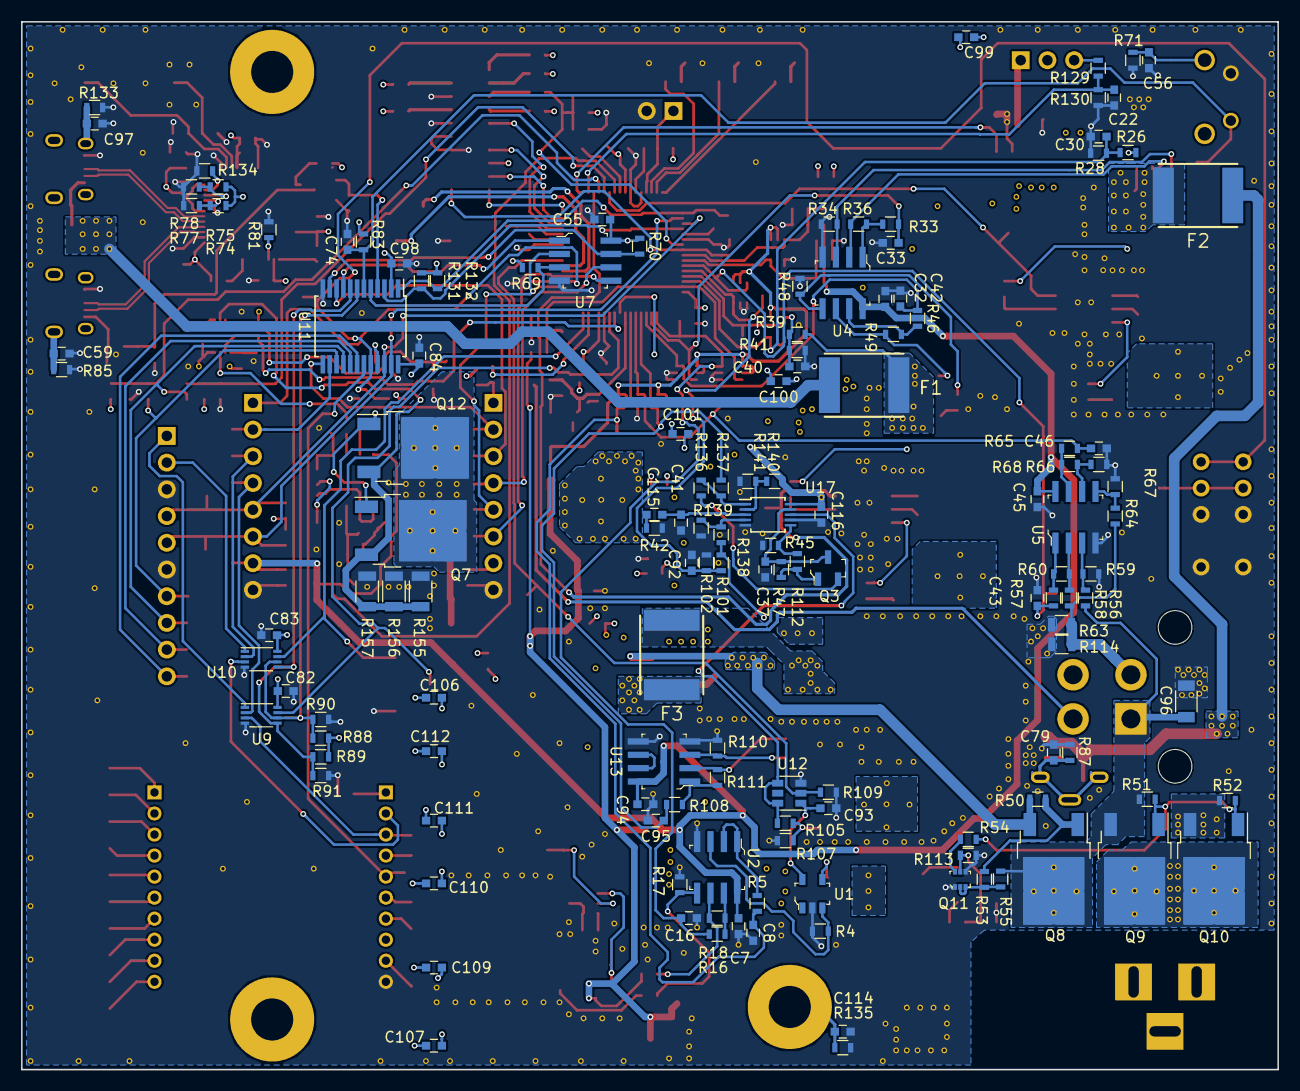
[picture p25: board NAS_Controller.kicad_pcb from below]

Board: 4 copper layers, 119.5 x 99.6 mm, 433 parts (139 on the bottom side), 220 nets.

Other parts of the board:
5.2A_I, 5.2A_V, 5.2B_I, 5.2B_V: Measurement_Point_Round-SMD-Pad_Small
BATT_I: Measurement_Point_Round-SMD-Pad_Small
BATT_V: Measurement_Point_Round-SMD-Pad_Small
BTEMP: Measurement_Point_Round-SMD-Pad_Small
ELOAD_PWM: Measurement_Point_Round-SMD-Pad_Small
ELOAD_SEL: Measurement_Point_Round-SMD-Pad_Small
FAN_PWM: Measurement_Point_Round-SMD-Pad_Small
FB: Measurement_Point_Round-SMD-Pad_Small
GND: Measurement_Point_Round-SMD-Pad_Small
MCS1: Measurement_Point_Round-SMD-Pad_Small
MISO: Measurement_Point_Round-SMD-Pad_Small
MK1#2, MK1#3: Mounting_Hole_PAD; MountingHole_4mm_Pad
MOSI: Measurement_Point_Round-SMD-Pad_Small
MRST: Measurement_Point_Round-SMD-Pad_Small
MSCK: Measurement_Point_Round-SMD-Pad_Small
MUX_UART_S0, MUX_UART_S1: Measurement_Point_Round-SMD-Pad_Small
M_INT: Measurement_Point_Round-SMD-Pad_Small
PIRX: Measurement_Point_Round-SMD-Pad_Small
PITX: Measurement_Point_Round-SMD-Pad_Small
PI_G0, PI_G1, PI_G2, PI_G3: Measurement_Point_Round-SMD-Pad_Small
PWM_5.2A, PWM_5.2B: Measurement_Point_Round-SMD-Pad_Small
PWM_SEPIC: Measurement_Point_Round-SMD-Pad_Small
PWR_SW: Measurement_Point_Round-SMD-Pad_Small
RST_SW: Measurement_Point_Round-SMD-Pad_Small
SCL: Measurement_Point_Round-SMD-Pad_Small
SDA: Measurement_Point_Round-SMD-Pad_Small
SEPIC_I: Measurement_Point_Round-SMD-Pad_Small
SEPIC_V: Measurement_Point_Round-SMD-Pad_Small
UART_XBEE_RX: Measurement_Point_Round-SMD-Pad_Small
UART_XBEE_TX: Measurement_Point_Round-SMD-Pad_Small
UMRX: Measurement_Point_Round-SMD-Pad_Small
UMTX: Measurement_Point_Round-SMD-Pad_Small
VAUX_I: Measurement_Point_Round-SMD-Pad_Small
VAUX_V: Measurement_Point_Round-SMD-Pad_Small
VCC: Measurement_Point_Round-SMD-Pad_Small
VIN: Measurement_Point_Round-SMD-Pad_Small
VIN_I: Measurement_Point_Round-SMD-Pad_Small
VIN_V: Measurement_Point_Round-SMD-Pad_Small
VREF: Measurement_Point_Round-SMD-Pad_Small

Their connections:
ADC_5V2_A_I: 5.2A_I.1; also elsewhere on the board
ADC_5V2_A_V: 5.2A_V.1; also elsewhere on the board
ADC_5V2_B_I: 5.2B_I.1; also elsewhere on the board
ADC_5V2_B_V: 5.2B_V.1; also elsewhere on the board
ADC_BATT_I: BATT_I.1; also elsewhere on the board
ADC_BATT_TEMP: BTEMP.1; also elsewhere on the board
ADC_BATT_V: BATT_V.1; also elsewhere on the board
ADC_SEPIC_I: SEPIC_I.1; also elsewhere on the board
ADC_SEPIC_V: SEPIC_V.1; also elsewhere on the board
ADC_VAUX_I: VAUX_I.1; also elsewhere on the board
ADC_VAUX_V: VAUX_V.1; also elsewhere on the board
ADC_VIN_I: VIN_I.1; also elsewhere on the board
ADC_VIN_V: VIN_V.1; also elsewhere on the board
ELOAD_PWM: ELOAD_PWM.1; also elsewhere on the board
ELOAD_SEL: ELOAD_SEL.1; also elsewhere on the board
FAN_PWM: FAN_PWM.1; also elsewhere on the board
GND: GND.1; also elsewhere on the board
I2C_SCL: SCL.1; also elsewhere on the board
I2C_SDA: SDA.1; also elsewhere on the board
MIKROE_INT: M_INT.1; also elsewhere on the board
MIKROE_RST: MRST.1; also elsewhere on the board
MUX_UART_S0: MUX_UART_S0.1; also elsewhere on the board
MUX_UART_S1: MUX_UART_S1.1; also elsewhere on the board
unnamed 74: MK1#3.1; also elsewhere on the board
unnamed 79: VREF.1; also elsewhere on the board
unnamed 181: FB.1; also elsewhere on the board
PI_G0: PI_G0.1; also elsewhere on the board
PI_G1: PI_G1.1; also elsewhere on the board
PI_G2: PI_G2.1; also elsewhere on the board
PI_G3: PI_G3.1; also elsewhere on the board
PWM_5V2_A: PWM_5.2A.1; also elsewhere on the board
PWM_5V2_B: PWM_5.2B.1; also elsewhere on the board
PWM_SEPIC: PWM_SEPIC.1; also elsewhere on the board
PWR_SW_IN: PWR_SW.1; also elsewhere on the board
RST_SW_IN: RST_SW.1; also elsewhere on the board
SPI_CS1_MIKROE: MCS1.1; also elsewhere on the board
SPI_MISO: MISO.1; also elsewhere on the board
SPI_MOSI: MOSI.1; also elsewhere on the board
SPI_SCK: MSCK.1; also elsewhere on the board
UART_MIKROE_RX: UMRX.1; also elsewhere on the board
UART_MIKROE_TX: UMTX.1; also elsewhere on the board
UART_XBEE_TX: UART_XBEE_TX.1; also elsewhere on the board
VCC: VCC.1; also elsewhere on the board
Vin: VIN.1; also elsewhere on the board
