EEJeffMan/NAS_Controller/Firmware/gpio.c

/*
 * gpio.c
 *
 *  Created on: Feb 16, 2019
 *      Author: Jeff
 */

#include "DSP2803x_Device.h"     // DSP2803x Headerfile Include File
#include "DSP2803x_Examples.h"   // DSP2803x Examples Include File
#include "gpio.h"
#include "main.h"

void init_gpio()
{
    //--------------------------------------------------------------------------------------
    // GPIO (GENERAL PURPOSE I/O) CONFIG
    //--------------------------------------------------------------------------------------
    //-----------------------
    // QUICK NOTES on USAGE:
    //-----------------------
    // If GpioCtrlRegs.GP?MUX?bit.GPIO?= 1, 2 or 3 (i.e. Non GPIO func), then leave
    //  rest of lines commented
    // If GpioCtrlRegs.GP?MUX?bit.GPIO?= 0 (i.e. GPIO func), then:
    //  1) uncomment GpioCtrlRegs.GP?DIR.bit.GPIO? = ? and choose pin to be IN or OUT
    //  2) If IN, can leave next to lines commented
    //  3) If OUT, uncomment line with ..GPACLEAR.. to force pin LOW or
    //             uncomment line with ..GPASET.. to force pin HIGH or
    //--------------------------------------------------------------------------------------
    EALLOW;
#ifdef PWM_ENABLE
    //--------------------------------------------------------------------------------------
    //  GPIO-00 - PIN FUNCTION = PWM1A (was Vaux, now TP2)
        GpioCtrlRegs.GPAMUX1.bit.GPIO0 = 1;     // 0=GPIO,  1=EPWM1A,  2=Resv,  3=Resv
    //  GpioCtrlRegs.GPADIR.bit.GPIO0 = 1;      // 1=OUTput,  0=INput
    //  GpioDataRegs.GPACLEAR.bit.GPIO0 = 1;    // uncomment if --> Set Low initially
    //  GpioDataRegs.GPASET.bit.GPIO0 = 1;      // uncomment if --> Set High initially
    //--------------------------------------------------------------------------------------
    //  GPIO-01 - PIN FUNCTION = ELOAD_PWM
        GpioCtrlRegs.GPAMUX1.bit.GPIO1 = 1;     // 0=GPIO,  1=EPWM1B,  2=Resv,  3=COMP1OUT
        GpioCtrlRegs.GPADIR.bit.GPIO1 = 1;      // 1=OUTput,  0=INput
        GpioDataRegs.GPACLEAR.bit.GPIO1 = 1;    // uncomment if --> Set Low initially
    //  GpioDataRegs.GPASET.bit.GPIO1 = 1;      // uncomment if --> Set High initially
#else
    //--------------------------------------------------------------------------------------
    //  GPIO-00 - PIN FUNCTION = PWM1A (Vaux)
        GpioCtrlRegs.GPAMUX1.bit.GPIO0 = 0;     // 0=GPIO,  1=EPWM1A,  2=Resv,  3=Resv
        GpioCtrlRegs.GPADIR.bit.GPIO0 = 0;      // 1=OUTput,  0=INput
    //  GpioDataRegs.GPACLEAR.bit.GPIO0 = 1;    // uncomment if --> Set Low initially
    //  GpioDataRegs.GPASET.bit.GPIO0 = 1;      // uncomment if --> Set High initially
    //--------------------------------------------------------------------------------------
    //  GPIO-01 - PIN FUNCTION = ELOAD_PWM
        GpioCtrlRegs.GPAMUX1.bit.GPIO1 = 0;     // 0=GPIO,  1=EPWM1B,  2=Resv,  3=COMP1OUT
        GpioCtrlRegs.GPADIR.bit.GPIO1 = 0;      // 1=OUTput,  0=INput
    //  GpioDataRegs.GPACLEAR.bit.GPIO1 = 1;    // uncomment if --> Set Low initially
    //  GpioDataRegs.GPASET.bit.GPIO1 = 1;      // uncomment if --> Set High initially
#endif
#ifdef PWM_ENABLE
    //--------------------------------------------------------------------------------------
    //  GPIO-02 - PIN FUNCTION = PWM2A (5V2_A)
        GpioCtrlRegs.GPAMUX1.bit.GPIO2 = 1;     // 0=GPIO,  1=EPWM2A,  2=Resv,  3=Resv
    //  GpioCtrlRegs.GPADIR.bit.GPIO2 = 0;      // 1=OUTput,  0=INput
    //  GpioDataRegs.GPACLEAR.bit.GPIO2 = 1;    // uncomment if --> Set Low initially
    //  GpioDataRegs.GPASET.bit.GPIO2 = 1;      // uncomment if --> Set High initially
#else
    //--------------------------------------------------------------------------------------
    //  GPIO-02 - PIN FUNCTION = PWM2A (5V2_A)
        GpioCtrlRegs.GPAMUX1.bit.GPIO2 = 0;     // 0=GPIO,  1=EPWM2A,  2=Resv,  3=Resv
        GpioCtrlRegs.GPADIR.bit.GPIO2 = 1;      // 1=OUTput,  0=INput
    //  GpioDataRegs.GPACLEAR.bit.GPIO2 = 1;    // uncomment if --> Set Low initially
        GpioDataRegs.GPASET.bit.GPIO2 = 1;      // uncomment if --> Set High initially
#endif
    //--------------------------------------------------------------------------------------
    //  GPIO-03 - PIN FUNCTION = Digital out (PI_RST_OUT)
        GpioCtrlRegs.GPAMUX1.bit.GPIO3 = 0;     // 0=GPIO,  1=EPWM2B,  2=SPISOMI-A,  3=COMP2OUT
        GpioCtrlRegs.GPADIR.bit.GPIO3 = 1;      // 1=OUTput,  0=INput
        GpioDataRegs.GPACLEAR.bit.GPIO3 = 1;    // uncomment if --> Set Low initially
    //  GpioDataRegs.GPASET.bit.GPIO3 = 1;      // uncomment if --> Set High initially
#ifdef PWM_ENABLE
    //--------------------------------------------------------------------------------------
    //  GPIO-04 - PIN FUNCTION = PWM3A (5V2_B)
        GpioCtrlRegs.GPAMUX1.bit.GPIO4 = 1;     // 0=GPIO,  1=EPWM3A,  2=Resv,  3=Resv
    //  GpioCtrlRegs.GPADIR.bit.GPIO4 = 0;      // 1=OUTput,  0=INput
    //  GpioDataRegs.GPACLEAR.bit.GPIO4 = 1;    // uncomment if --> Set Low initially
    //  GpioDataRegs.GPASET.bit.GPIO4 = 1;      // uncomment if --> Set High initially
#else
    //--------------------------------------------------------------------------------------
    //  GPIO-04 - PIN FUNCTION = PWM3A (5V2_B)
        GpioCtrlRegs.GPAMUX1.bit.GPIO4 = 0;     // 0=GPIO,  1=EPWM3A,  2=Resv,  3=Resv
        GpioCtrlRegs.GPADIR.bit.GPIO4 = 1;      // 1=OUTput,  0=INput
    //  GpioDataRegs.GPACLEAR.bit.GPIO4 = 1;    // uncomment if --> Set Low initially
        GpioDataRegs.GPASET.bit.GPIO4 = 1;      // uncomment if --> Set High initially
#endif
    //--------------------------------------------------------------------------------------
    //  GPIO-05 - PIN FUNCTION = Fan feedback (Ecap?)
        GpioCtrlRegs.GPAMUX1.bit.GPIO5 = 3;     // 0=GPIO,  1=EPWM3B,  2=SPISIMO-A,  3=ECAP1
    //  GpioCtrlRegs.GPADIR.bit.GPIO5 = 0;      // 1=OUTput,  0=INput
    //  GpioDataRegs.GPACLEAR.bit.GPIO5 = 1;    // uncomment if --> Set Low initially
    //  GpioDataRegs.GPASET.bit.GPIO5 = 1;      // uncomment if --> Set High initially
#ifdef PWM_ENABLE
    //--------------------------------------------------------------------------------------
    //  GPIO-06 - PIN FUNCTION = PWM4A (SEPIC)
        GpioCtrlRegs.GPAMUX1.bit.GPIO6 = 1;     // 0=GPIO,  1=EPWM4A,  2=SYNCI,  3=SYNCO
    //  GpioCtrlRegs.GPADIR.bit.GPIO6 = 0;      // 1=OUTput,  0=INput
    //  GpioDataRegs.GPACLEAR.bit.GPIO6 = 1;    // uncomment if --> Set Low initially
    //  GpioDataRegs.GPASET.bit.GPIO6 = 1;      // uncomment if --> Set High initially
#else
    //--------------------------------------------------------------------------------------
    //  GPIO-06 - PIN FUNCTION = PWM4A (SEPIC)
        GpioCtrlRegs.GPAMUX1.bit.GPIO6 = 0;     // 0=GPIO,  1=EPWM4A,  2=SYNCI,  3=SYNCO
        GpioCtrlRegs.GPADIR.bit.GPIO6 = 0;      // 1=OUTput,  0=INput
    //  GpioDataRegs.GPACLEAR.bit.GPIO6 = 1;    // uncomment if --> Set Low initially
    //  GpioDataRegs.GPASET.bit.GPIO6 = 1;      // uncomment if --> Set High initially
#endif
    //--------------------------------------------------------------------------------------
    //  GPIO-07 - PIN FUNCTION = DEBUG_UART_RX
        GpioCtrlRegs.GPAMUX1.bit.GPIO7 = 2;     // 0=GPIO,  1=EPWM4B,  2=SCIRX-A,  3=Resv
    //  GpioCtrlRegs.GPADIR.bit.GPIO7 = 1;      // 1=OUTput,  0=INput
    //  GpioDataRegs.GPACLEAR.bit.GPIO7 = 1;    // uncomment if --> Set Low initially
    //  GpioDataRegs.GPASET.bit.GPIO7 = 1;      // uncomment if --> Set High initially
    //--------------------------------------------------------------------------------------
    //  GPIO-08 - PIN FUNCTION = PWM5A (MIKROE)
        GpioCtrlRegs.GPAMUX1.bit.GPIO8 = 1;     // 0=GPIO,  1=EPWM5A,  2=Resv,  3=ADCSOC-A
    //  GpioCtrlRegs.GPADIR.bit.GPIO8 = 0;      // 1=OUTput,  0=INput
    //  GpioDataRegs.GPACLEAR.bit.GPIO8 = 1;    // uncomment if --> Set Low initially
    //  GpioDataRegs.GPASET.bit.GPIO8 = 1;      // uncomment if --> Set High initially
    //--------------------------------------------------------------------------------------
    //  GPIO-09 - PIN FUNCTION = Digital in (MIKROE AN)
        GpioCtrlRegs.GPAMUX1.bit.GPIO9 = 0;     // 0=GPIO,  1=EPWM5B,  2=LINTX-A,  3=Resv
        GpioCtrlRegs.GPADIR.bit.GPIO9 = 0;      // 1=OUTput,  0=INput
    //  GpioDataRegs.GPACLEAR.bit.GPIO9 = 1;    // uncomment if --> Set Low initially
    //  GpioDataRegs.GPASET.bit.GPIO9 = 1;      // uncomment if --> Set High initially
    //--------------------------------------------------------------------------------------
    //  GPIO-10 - PIN FUNCTION = Digital out (PI_PWR_OUT)
        GpioCtrlRegs.GPAMUX1.bit.GPIO10 = 0;    // 0=GPIO,  1=EPWM6A,  2=Resv,  3=ADCSOC-B
        GpioCtrlRegs.GPADIR.bit.GPIO10 = 1;     // 1=OUTput,  0=INput
        GpioDataRegs.GPACLEAR.bit.GPIO10 = 1;   // uncomment if --> Set Low initially
    //  GpioDataRegs.GPASET.bit.GPIO10 = 1;     // uncomment if --> Set High initially
#ifdef PWM_ENABLE
    //--------------------------------------------------------------------------------------
    //  GPIO-11 - PIN FUNCTION = PWM6B (Fan)
        GpioCtrlRegs.GPAMUX1.bit.GPIO11 = 1;    // 0=GPIO,  1=EPWM6B,  2=LINRX-A,  3=Resv
    //  GpioCtrlRegs.GPADIR.bit.GPIO11 = 0;     // 1=OUTput,  0=INput
    //  GpioDataRegs.GPACLEAR.bit.GPIO11 = 1;   // uncomment if --> Set Low initially
    //  GpioDataRegs.GPASET.bit.GPIO11 = 1;     // uncomment if --> Set High initially
#else
    //--------------------------------------------------------------------------------------
    //  GPIO-11 - PIN FUNCTION = PWM6B (Fan)
        GpioCtrlRegs.GPAMUX1.bit.GPIO11 = 0;    // 0=GPIO,  1=EPWM6B,  2=LINRX-A,  3=Resv
        GpioCtrlRegs.GPADIR.bit.GPIO11 = 0;     // 1=OUTput,  0=INput
    //  GpioDataRegs.GPACLEAR.bit.GPIO11 = 1;   // uncomment if --> Set Low initially
    //  GpioDataRegs.GPASET.bit.GPIO11 = 1;     // uncomment if --> Set High initially
#endif
    //--------------------------------------------------------------------------------------
    //  GPIO-12 - PIN FUNCTION = DEBUG_UART_TX
        GpioCtrlRegs.GPAMUX1.bit.GPIO12 = 2;    // 0=GPIO,  1=TZ1,  2=SCITX-A,  3=SPISIMO-B
    //  GpioCtrlRegs.GPADIR.bit.GPIO12 = 1;     // 1=OUTput,  0=INput
    //  GpioDataRegs.GPACLEAR.bit.GPIO12 = 1;   // uncomment if --> Set Low initially
    //  GpioDataRegs.GPASET.bit.GPIO12 = 1;     // uncomment if --> Set High initially
    //--------------------------------------------------------------------------------------
    //  GPIO-13 - PIN FUNCTION = NA
        GpioCtrlRegs.GPAMUX1.bit.GPIO13 = 0;    // 0=GPIO,  1=TZ2,  2=Resv,  3=SPISOMI-B
        GpioCtrlRegs.GPADIR.bit.GPIO13 = 0;     // 1=OUTput,  0=INput
    //  GpioDataRegs.GPACLEAR.bit.GPIO13 = 1;   // uncomment if --> Set Low initially
    //  GpioDataRegs.GPASET.bit.GPIO13 = 1;     // uncomment if --> Set High initially
    //--------------------------------------------------------------------------------------
    //  GPIO-14 - PIN FUNCTION = NA
        GpioCtrlRegs.GPAMUX1.bit.GPIO14 = 0;    // 0=GPIO,  1=TZ3,  2=LINTX-A,  3=SPICLK-B
        GpioCtrlRegs.GPADIR.bit.GPIO14 = 0;     // 1=OUTput,  0=INput
    //  GpioDataRegs.GPACLEAR.bit.GPIO14 = 1;   // uncomment if --> Set Low initially
    //  GpioDataRegs.GPASET.bit.GPIO14 = 1;     // uncomment if --> Set High initially
    //--------------------------------------------------------------------------------------
    //  GPIO-15 - PIN FUNCTION = NA
        GpioCtrlRegs.GPAMUX1.bit.GPIO15 = 0;    // 0=GPIO,  1=TZ1,  2=LINRX-A,  3=SPISTE-B
        GpioCtrlRegs.GPADIR.bit.GPIO15 = 0;     // 1=OUTput,  0=INput
    //  GpioDataRegs.GPACLEAR.bit.GPIO15 = 1;   // uncomment if --> Set Low initially
    //  GpioDataRegs.GPASET.bit.GPIO15 = 1;     // uncomment if --> Set High initially
    //--------------------------------------------------------------------------------------
    //--------------------------------------------------------------------------------------
    //  GPIO-16 - PIN FUNCTION = SPI_MOSI
        GpioCtrlRegs.GPAMUX2.bit.GPIO16 = 1;    // 0=GPIO,  1=SPISIMO-A,  2=Resv,  3=TZ2
    //  GpioCtrlRegs.GPADIR.bit.GPIO16 = 0;     // 1=OUTput,  0=INput
    //  GpioDataRegs.GPACLEAR.bit.GPIO16 = 1;   // uncomment if --> Set Low initially
    //  GpioDataRegs.GPASET.bit.GPIO16 = 1;     // uncomment if --> Set High initially
    //--------------------------------------------------------------------------------------
    //  GPIO-17 - PIN FUNCTION = SPI_MISO
        GpioCtrlRegs.GPAMUX2.bit.GPIO17 = 1;    // 0=GPIO,  1=SPISOMI-A,  2=Resv,  3=TZ3
    //  GpioCtrlRegs.GPADIR.bit.GPIO17 = 0;     // 1=OUTput,  0=INput
    //  GpioDataRegs.GPACLEAR.bit.GPIO17 = 1;   // uncomment if --> Set Low initially
    //  GpioDataRegs.GPASET.bit.GPIO17 = 1;     // uncomment if --> Set High initially
    //--------------------------------------------------------------------------------------
    //  GPIO-18 - PIN FUNCTION = SPI_SCK
        GpioCtrlRegs.GPAMUX2.bit.GPIO18 = 1;    // 0=GPIO,  1=SPICLK-A,  2=LINTX-A,  3=XCLKOUT
    //  GpioCtrlRegs.GPADIR.bit.GPIO18 = 0;     // 1=OUTput,  0=INput
    //  GpioDataRegs.GPACLEAR.bit.GPIO18 = 1;   // uncomment if --> Set Low initially
    //  GpioDataRegs.GPASET.bit.GPIO18 = 1;     // uncomment if --> Set High initially
    //--------------------------------------------------------------------------------------
    //  GPIO-19 - PIN FUNCTION = TP1
        GpioCtrlRegs.GPAMUX2.bit.GPIO19 = 0;    // 0=GPIO,  1=SPISTE-A,  2=LINRX-A,  3=ECAP1
        GpioCtrlRegs.GPADIR.bit.GPIO19 = 0;     // 1=OUTput,  0=INput
    //  GpioDataRegs.GPACLEAR.bit.GPIO19 = 1;   // uncomment if --> Set Low initially
    //  GpioDataRegs.GPASET.bit.GPIO19 = 1;     // uncomment if --> Set High initially
    //--------------------------------------------------------------------------------------
    //  GPIO-20 - PIN FUNCTION = Green LED
        GpioCtrlRegs.GPAMUX2.bit.GPIO20 = 0;    // 0=GPIO,  1=EQEPA-1,  2=Resv,  3=COMP1OUT
        GpioCtrlRegs.GPADIR.bit.GPIO20 = 1;     // 1=OUTput,  0=INput
        GpioDataRegs.GPACLEAR.bit.GPIO20 = 1;   // uncomment if --> Set Low initially
    //  GpioDataRegs.GPASET.bit.GPIO20 = 1;     // uncomment if --> Set High initially
    //--------------------------------------------------------------------------------------
    //  GPIO-21 - PIN FUNCTION = Yellow LED
        GpioCtrlRegs.GPAMUX2.bit.GPIO21 = 0;    // 0=GPIO,  1=EQEPB-1,  2=Resv,  3=COMP2OUT
        GpioCtrlRegs.GPADIR.bit.GPIO21 = 1;     // 1=OUTput,  0=INput
        GpioDataRegs.GPACLEAR.bit.GPIO21 = 1;   // uncomment if --> Set Low initially
    //  GpioDataRegs.GPASET.bit.GPIO21 = 1;     // uncomment if --> Set High initially
    //--------------------------------------------------------------------------------------
    //  GPIO-22 - PIN FUNCTION = IO expander interrupt input
        GpioCtrlRegs.GPAMUX2.bit.GPIO22 = 0;    // 0=GPIO,  1=EQEPS-1,  2=Resv,  3=LINTX-A
        GpioCtrlRegs.GPADIR.bit.GPIO22 = 0;     // 1=OUTput,  0=INput
    //  GpioDataRegs.GPACLEAR.bit.GPIO22 = 1;   // uncomment if --> Set Low initially
    //  GpioDataRegs.GPASET.bit.GPIO22 = 1;     // uncomment if --> Set High initially
    //--------------------------------------------------------------------------------------
    //  GPIO-23 - PIN FUNCTION = IO expander reset output
        GpioCtrlRegs.GPAMUX2.bit.GPIO23 = 0;    // 0=GPIO,  1=EQEPI-1,  2=Resv,  3=LINRX-A
        GpioCtrlRegs.GPADIR.bit.GPIO23 = 1;     // 1=OUTput,  0=INput
        GpioDataRegs.GPACLEAR.bit.GPIO23 = 1;   // uncomment if --> Set Low initially
    //  GpioDataRegs.GPASET.bit.GPIO23 = 1;     // uncomment if --> Set High initially
    //--------------------------------------------------------------------------------------
    //  GPIO-24 - PIN FUNCTION = Red LED
        GpioCtrlRegs.GPAMUX2.bit.GPIO24 = 0;    // 0=GPIO,  1=ECAP1,  2=Resv,  3=SPISIMO-B
        GpioCtrlRegs.GPADIR.bit.GPIO24 = 1;     // 1=OUTput,  0=INput
        GpioDataRegs.GPACLEAR.bit.GPIO24 = 1;   // uncomment if --> Set Low initially
    //  GpioDataRegs.GPASET.bit.GPIO24 = 1;     // uncomment if --> Set High initially
    //--------------------------------------------------------------------------------------
    //  GPIO-25 - PIN FUNCTION = NA
        GpioCtrlRegs.GPAMUX2.bit.GPIO25 = 3;    // 0=GPIO,  1=Resv,  2=Resv,  3=SPISOMI-B
    //  GpioCtrlRegs.GPADIR.bit.GPIO25 = 0;     // 1=OUTput,  0=INput
    //  GpioDataRegs.GPACLEAR.bit.GPIO25 = 1;   // uncomment if --> Set Low initially
    //  GpioDataRegs.GPASET.bit.GPIO25 = 1;     // uncomment if --> Set High initially
    //--------------------------------------------------------------------------------------
    //  GPIO-26 - PIN FUNCTION = NA
        GpioCtrlRegs.GPAMUX2.bit.GPIO26 = 3;    // 0=GPIO,  1=Resv,  2=Resv,  3=SPICLK-B
    //  GpioCtrlRegs.GPADIR.bit.GPIO26 = 0;     // 1=OUTput,  0=INput
    //  GpioDataRegs.GPACLEAR.bit.GPIO26 = 1;   // uncomment if --> Set Low initially
    //  GpioDataRegs.GPASET.bit.GPIO26 = 1;     // uncomment if --> Set High initially
    //--------------------------------------------------------------------------------------
    //  GPIO-27 - PIN FUNCTION = NA
        GpioCtrlRegs.GPAMUX2.bit.GPIO27 = 3;    // 0=GPIO,  1=Resv,  2=Resv,  3=SPISTE-B
    //  GpioCtrlRegs.GPADIR.bit.GPIO27 = 0;     // 1=OUTput,  0=INput
    //  GpioDataRegs.GPACLEAR.bit.GPIO27 = 1;   // uncomment if --> Set Low initially
    //  GpioDataRegs.GPASET.bit.GPIO27 = 1;     // uncomment if --> Set High initially
    //--------------------------------------------------------------------------------------
    //  GPIO-28 - PIN FUNCTION = UART_COM_RX
        GpioCtrlRegs.GPAMUX2.bit.GPIO28 = 1;    // 0=GPIO,  1=SCIRX-A,  2=I2CSDA-A,  3=TZ2
    //  GpioCtrlRegs.GPADIR.bit.GPIO28 = 1;     // 1=OUTput,  0=INput
    //  GpioDataRegs.GPACLEAR.bit.GPIO28 = 1;   // uncomment if --> Set Low initially
    //  GpioDataRegs.GPASET.bit.GPIO28 = 1;     // uncomment if --> Set High initially
    //--------------------------------------------------------------------------------------
    //  GPIO-29 - PIN FUNCTION = UART_COM_TX
        GpioCtrlRegs.GPAMUX2.bit.GPIO29 = 1;    // 0=GPIO,  1=SCITXD-A,  2=I2CSCL-A,  3=TZ3
    //  GpioCtrlRegs.GPADIR.bit.GPIO29 = 0;     // 1=OUTput,  0=INput
    //  GpioDataRegs.GPACLEAR.bit.GPIO29 = 1;   // uncomment if --> Set Low initially
    //  GpioDataRegs.GPASET.bit.GPIO29 = 1;     // uncomment if --> Set High initially
    //--------------------------------------------------------------------------------------
    //  GPIO-30 - PIN FUNCTION = ELOAD_SEL
        GpioCtrlRegs.GPAMUX2.bit.GPIO30 = 0;    // 0=GPIO,  1=CANRX-A,  2=Resv,  3=Resv
        GpioCtrlRegs.GPADIR.bit.GPIO30 = 1;     // 1=OUTput,  0=INput
    //  GpioDataRegs.GPACLEAR.bit.GPIO30 = 1;   // uncomment if --> Set Low initially
        GpioDataRegs.GPASET.bit.GPIO30 = 1;     // uncomment if --> Set High initially
    //--------------------------------------------------------------------------------------
    //  GPIO-31 - PIN FUNCTION = TP4
        GpioCtrlRegs.GPAMUX2.bit.GPIO31 = 0;    // 0=GPIO,  1=CANTX-A,  2=Resv,  3=Resv
        GpioCtrlRegs.GPADIR.bit.GPIO31 = 0;     // 1=OUTput,  0=INput
    //  GpioDataRegs.GPACLEAR.bit.GPIO31 = 1;   // uncomment if --> Set Low initially
    //  GpioDataRegs.GPASET.bit.GPIO31 = 1;     // uncomment if --> Set High initially
    //--------------------------------------------------------------------------------------
    //--------------------------------------------------------------------------------------
    //  GPIO-32 - PIN FUNCTION = I2C_SDA
        GpioCtrlRegs.GPBMUX1.bit.GPIO32 = 1;    // 0=GPIO,  1=I2CSDA-A,  2=SYNCI,  3=ADCSOCA
    //  GpioCtrlRegs.GPBDIR.bit.GPIO32 = 0;     // 1=OUTput,  0=INput
    //  GpioDataRegs.GPBCLEAR.bit.GPIO32 = 1;   // uncomment if --> Set Low initially
    //  GpioDataRegs.GPBSET.bit.GPIO32 = 1;     // uncomment if --> Set High initially
    //--------------------------------------------------------------------------------------
    //  GPIO-33 - PIN FUNCTION = I2C_SCL
        GpioCtrlRegs.GPBMUX1.bit.GPIO33 = 1;    // 0=GPIO,  1=I2CSCL-A,  2=SYNCO,  3=ADCSOCB
    //  GpioCtrlRegs.GPBDIR.bit.GPIO33 = 1;     // 1=OUTput,  0=INput
    //  GpioDataRegs.GPBCLEAR.bit.GPIO33 = 1;   // uncomment if --> Set Low initially
    //  GpioDataRegs.GPBSET.bit.GPIO33 = 1;     // uncomment if --> Set High initially
    //--------------------------------------------------------------------------------------
    //  GPIO-34 - PIN FUNCTION = BOOT_MODE
        GpioCtrlRegs.GPBMUX1.bit.GPIO34 = 0;    // 0=GPIO,  1=Resv,  2=Resv,  3=Resv
        GpioCtrlRegs.GPBDIR.bit.GPIO34 = 0;     // 1=OUTput,  0=INput
    //  GpioDataRegs.GPBCLEAR.bit.GPIO34 = 1;   // uncomment if --> Set Low initially
    //  GpioDataRegs.GPBSET.bit.GPIO34 = 1;     // uncomment if --> Set High initially
    //--------------------------------------------------------------------------------------
    //--------------------------------------------------------------------------------------
    // GPIO 35-38 are defaulted to JTAG usage, and are not shown here to enforce JTAG debug
    // usage.
    //--------------------------------------------------------------------------------------
    //--------------------------------------------------------------------------------------

    // GPIO 39-44 are not on the 28035 device used.
    //  GPIO-39 - PIN FUNCTION = NA
        GpioCtrlRegs.GPBMUX1.bit.GPIO39 = 0;    // 0=GPIO,  1=Resv,  2=Resv,  3=Resv
        GpioCtrlRegs.GPBDIR.bit.GPIO39 = 0;     // 1=OUTput,  0=INput
    //  GpioDataRegs.GPBCLEAR.bit.GPIO39 = 1;   // uncomment if --> Set Low initially
    //  GpioDataRegs.GPBSET.bit.GPIO39 = 1;     // uncomment if --> Set High initially
    //--------------------------------------------------------------------------------------
    //  GPIO-40 - PIN FUNCTION = NA
        GpioCtrlRegs.GPBMUX1.bit.GPIO40 = 0;    // 0=GPIO,  1=EPWM7A,  2=Resv,  3=Resv
        GpioCtrlRegs.GPBDIR.bit.GPIO40 = 0;     // 1=OUTput,  0=INput
    //  GpioDataRegs.GPBCLEAR.bit.GPIO40 = 1;   // uncomment if --> Set Low initially
    //  GpioDataRegs.GPBSET.bit.GPIO40 = 1;     // uncomment if --> Set High initially
    //--------------------------------------------------------------------------------------
    //  GPIO-41 - PIN FUNCTION = NA
        GpioCtrlRegs.GPBMUX1.bit.GPIO41 = 0;    // 0=GPIO,  1=EPWM7B,  2=Resv,  3=Resv
        GpioCtrlRegs.GPBDIR.bit.GPIO41 = 0;     // 1=OUTput,  0=INput
    //  GpioDataRegs.GPBCLEAR.bit.GPIO41 = 1;   // uncomment if --> Set Low initially
    //  GpioDataRegs.GPBSET.bit.GPIO41 = 1;     // uncomment if --> Set High initially
    //--------------------------------------------------------------------------------------
    //  GPIO-42 - PIN FUNCTION = NA
        GpioCtrlRegs.GPBMUX1.bit.GPIO42 = 0;    // 0=GPIO,  1=Resv,  2=Resv,  3=COMP1OUT
        GpioCtrlRegs.GPBDIR.bit.GPIO42 = 0; // 1=OUTput,  0=INput
    //  GpioDataRegs.GPBCLEAR.bit.GPIO42 = 1;   // uncomment if --> Set Low initially
    //  GpioDataRegs.GPBSET.bit.GPIO42 = 1;     // uncomment if --> Set High initially
    //--------------------------------------------------------------------------------------
    //  GPIO-43 - PIN FUNCTION = NA
        GpioCtrlRegs.GPBMUX1.bit.GPIO43 = 0;    // 0=GPIO,  1=Resv,  2=Resv,  3=COMP2OUT
        GpioCtrlRegs.GPBDIR.bit.GPIO43 = 0;     // 1=OUTput,  0=INput
    //  GpioDataRegs.GPBCLEAR.bit.GPIO43 = 1;   // uncomment if --> Set Low initially
    //  GpioDataRegs.GPBSET.bit.GPIO43 = 1;     // uncomment if --> Set High initially
    //--------------------------------------------------------------------------------------
    //  GPIO-44 - PIN FUNCTION = NA
        GpioCtrlRegs.GPBMUX1.bit.GPIO44 = 0;    // 0=GPIO,  1=Resv,  2=Resv,  3=Resv
        GpioCtrlRegs.GPBDIR.bit.GPIO44 = 0;     // 1=OUTput,  0=INput
    //  GpioDataRegs.GPBCLEAR.bit.GPIO44 = 1;   // uncomment if --> Set Low initially
    //  GpioDataRegs.GPBSET.bit.GPIO44 = 1;     // uncomment if --> Set High initially
    //--------------------------------------------------------------------------------------
    //--------------------------------------------------------------------------------------
        EDIS;   // Disable register access
}

//end of file.
