EEJeffMan/NAS_Controller/Firmware/main.h

/*
 * main.h
 *
 *  Created on: Jul 16, 2018
 *      Author: Jeff
 */

#ifndef MAIN_H_
#define MAIN_H_

//#define CLA_ENABLE
#define ADC_ENABLE
#define PWM_ENABLE
#define LED_ENABLE
#define UART_ENABLE
#define TASK_SCHEDULER_ENABLE
//#define I2C_ENABLE

#endif /* MAIN_H_ */
