EEJeffMan/NAS_Controller/Firmware/smps.h

/*
 * smps.h
 *
 *  Created on: Jul 16, 2018
 *      Author: Jeff
 */

#ifndef SMPS_H_
#define SMPS_H_

// comment out to disable PWM
#define PWM_ENABLE_ELOAD
#define PWM_ENABLE_5V2A
#define PWM_ENABLE_5V2B
#define PWM_ENABLE_SEPIC

// TBCLK period = 60000 (60MHz)
#define ELOAD_PERIOD        600     // period = TBCLK period * VAUX_PERIOD... 600 = 100kHz
#define PERIOD_5V2_A        60      // period = TBCLK period * VAUX_PERIOD... 60 = 1MHz
#define PERIOD_5V2_B        60      // period = TBCLK period * VAUX_PERIOD... 60 = 1MHz
#define SEPIC_PERIOD        240     // period = TBCLK period * VAUX_PERIOD... 240 = 250kHz

#define DUTY_ELOAD          6       // 6/600 = 1% duty cycle @ 100kHz... PWM in ELOAD will be inverse of this.
#define DUTY_5V2A           30      // 30/60 = 50% duty cycle @ 1MHz
#define DUTY_5V2B           30      //
#define DUTY_SEPIC          80      // 80/240 = 33.3% @ 250kHz

void init_smps();

#endif /* SMPS_H_ */
