EEJeffMan/NAS_Controller/(commit log)

2018-07-24 Initial commit for PCB and Firmware
    PCB: KiCAD 4.0.7
    Firmware: Code Composer 8.1.0.00011 with C2000WARE 1.00.05.00
    [5V2_Supplies.sch, Battery_Charger.sch, Buck_Converters.sch, IO.sch, Input.sch, MCU.sch, MCU_SUPPORT.sch, NAS_Controller.kicad_pcb]
2018-07-25 Enabled task scheduler, and added ADC test code (not yet working)
    ADCINT1 is not being entered, and ADCs are not being read.
2018-07-26 Updated ADC code
    Fixed ADC test code, now successfully samples and stores all channels.
    [main.c, task_scheduler.c]
2018-07-26 ADC debugging progress
    Moved from round robin sampling for all to simultaneous high priority samples on ADCINT1 and lower priority round robin samples to ADCINT2. ADC data appears to be invalid...
2018-07-28 Changed ADC config from simultaneous to sequential, and created spreadsheet to track ADC register settings.
    [ADC Config.xlsx]
2018-07-29 Renamed spreadsheeet to "Peripherals" and expanded from ADC only to EPWM; added duty cycle initializations for each power supply output.
    [ADC Config.xlsx, Peripherals.xlsx]
2018-07-29 Enabled PWM, reduced Vaux duty cycle for testing.
2018-08-01 Reduced switching frequencies to 150kHz, and set to 33% duty cycle; created spice simulation for gate drive circuit.
2018-11-15 Rev02 schematic done, layout started
2018-11-16 Fixed footprint library issue & made progress on layout.
    [NAS_Controller.kicad_pcb]
2018-11-18 Added R142, updated layout
    [5V2_Supplies.sch, Battery_Charger.sch, IO.sch, MCU.sch, MCU_SUPPORT.sch, NAS_Controller.kicad_pcb, SEPIC.sch, Signal_Conditioning.sch]
2018-11-19 Layout updates
    [NAS_Controller.kicad_pcb]
2018-11-19 Layout... finished routing, now need to stitch vias, reveiew pours and then silkscreen.
    [NAS_Controller.kicad_pcb]
2018-11-20 Added I2C code
2018-11-20 Added stitching vias; one unconnected net left, then silkscreen.
    [NAS_Controller.kicad_pcb]
2018-11-20 Fixed last missing connection.
    [NAS_Controller.kicad_pcb]
2018-11-20 Updated silkscreen and generated rev02 gerbers, need to review.
    [NAS_Controller.kicad_pcb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]
2018-11-21 Added ELOAD to sch and imported to layout
    [5V2_Supplies.sch, Battery_Charger.sch, Eload.sch, IO.sch, Input.sch, MCU.sch, MCU_SUPPORT.sch, NAS_Controller.kicad_pcb]
2018-11-21 Updated placement of electric load.
    [NAS_Controller.kicad_pcb]
2018-11-24 Finished routing updates and started adding stitching vias (many were removed on last sch update).
    [NAS_Controller.kicad_pcb]
2018-11-24 Finished stitching vias, worked through DRC's, generated gerbers (need to review).
    [NAS_Controller-B.Cu.gbr, NAS_Controller-B.Mask.gbr, NAS_Controller-B.Paste.gbr, NAS_Controller-B.SilkS.gbr, NAS_Controller-Edge.Cuts.gbr, NAS_Controller-F.Cu.gbr, NAS_Controller-F.Mask.gbr, NAS_Controller-F.Paste.gbr]
2018-11-25 Re-generated schematic, started adding test points, still need to add mtg holes.
    [NAS_Controller.kicad_pcb]
2018-11-25 Added the rest of the test points & routed them, still need to update silkscreen and add mth holes.
    [NAS_Controller.kicad_pcb]
2018-11-26 Started working on silkscreen
    [NAS_Controller.kicad_pcb]
2018-11-27 Finished top silkscreen, need to review bottom silkscreen and re-run DRCs
    [NAS_Controller.kicad_pcb]
2018-11-28 Finished silkscreen and DRC's, still need to add mtg holes
    [NAS_Controller.kicad_pcb]
2018-11-28 Fixed silkscreen, added mounting holes, and re-generated gerbers.
    Need to review once more, and do a physical check out of connectors and mounting holes on hardware.
    [NAS_Controller-B.Cu.gbr, NAS_Controller-B.Mask.gbr, NAS_Controller-B.Paste.gbr, NAS_Controller-B.SilkS.gbr, NAS_Controller-Edge.Cuts.gbr, NAS_Controller-F.Cu.gbr, NAS_Controller-F.Mask.gbr, NAS_Controller-F.Paste.gbr]
2018-11-30 Updated connectors and parts per mechanicaly fit check, see description for details.
    Removed upper right mtg hole and cleared copper and components nearby... moved reset switch closer to board edge... moved J3 and fixed mounting holes in footprint... moved components too close to fan connector on top.
    [NAS_Controller.kicad_pcb]
2018-11-30 Moved components & copper away from mtg holes.
    [NAS_Controller.kicad_pcb]
2018-12-05 Updated switch, need to re-position for alignment...
    [5V2_Supplies.sch, Battery_Charger.sch, Eload.sch, IO.sch, Input.sch, MCU.sch, MCU_SUPPORT.sch, NAS_Controller.kicad_pcb]
2018-12-08 Layout update, need to update USB connector footprint
    [NAS_Controller.kicad_pcb]
2019-01-17 Final rev02 PCB and prep firmware for first load with pinout changes.
    PCB: Updated to final gerbers
    Firmware: Updated PWM frequency and duty cycles... Changed EPWM1 from 1A to 1B for ELOAD... GPIO config: removed PWM from GPIO0, added it to GPIO1, and configured GPIO30 for ELOAD_SEL.
    [NAS_Controller-B.Cu.gbr, NAS_Controller-B.Mask.gbr, NAS_Controller-B.Paste.gbr, NAS_Controller-B.SilkS.gbr, NAS_Controller-Edge.Cuts.gbr, NAS_Controller-F.Cu.gbr, NAS_Controller-F.Mask.gbr, NAS_Controller-F.Paste.gbr]
2019-01-20 Moved all init code to "init" function, updated PWM frequencies & duty cycles.
2019-02-16 Created separate source files for gpio & uart, and tweaked smps config
2019-02-16 Created separate source files for adc & i2c, moved additional smps stuff into smps.c.
2019-02-23 Updated firmware to debug & test E-Load circuit, and added E-Load circuit spice model.
2019-02-27 Small firmware tweaks, and updated E-Load spice model for new E-load config (E-load driver off-board)
2019-03-03 Added i2c.c back into project, and updated i2c library... not done yet.
